bontorhumala/amelia-girl/models/CAD/snap 1.PNG

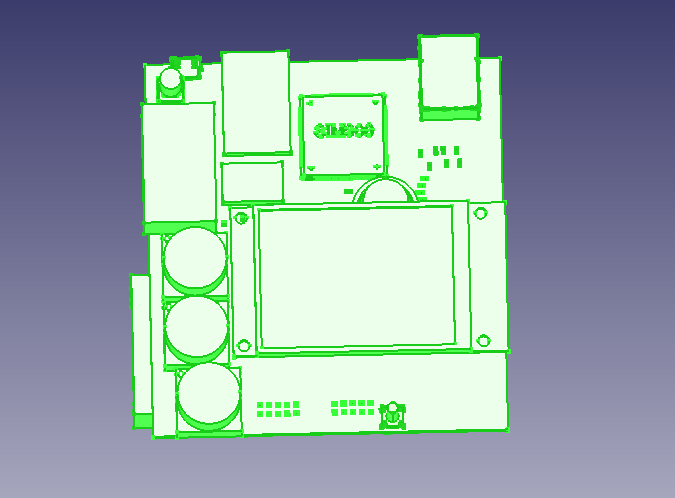
models/CAD/snap 1.PNG
