bontorhumala/amelia-girl/models/CAD/snap 3.PNG

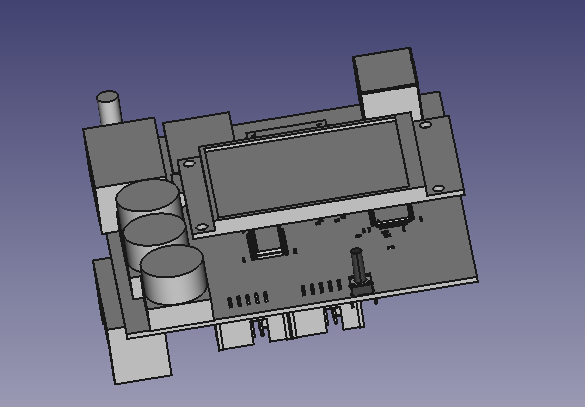
models/CAD/snap 3.PNG
