bontorhumala/amelia-girl/6lowPan/eagleUp/eagleUp_bontor_mbed_lowpan_rev_d_board_bottom.png

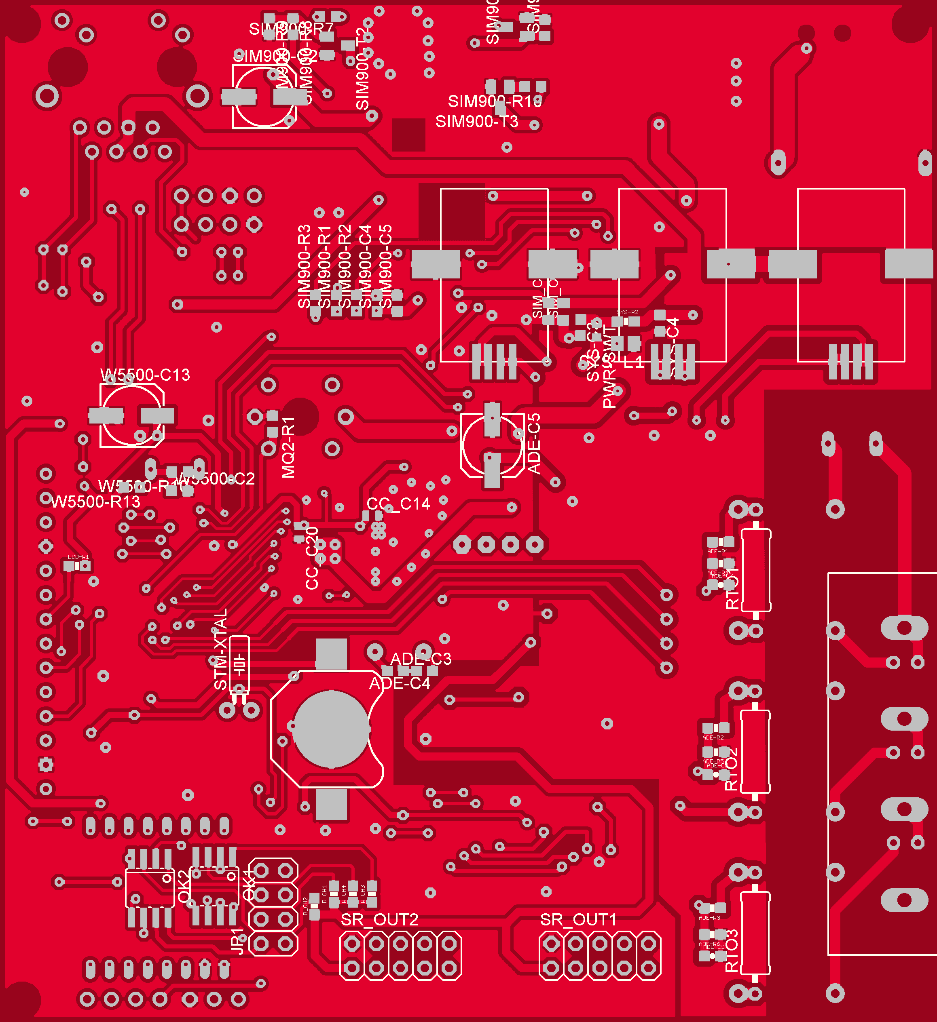
6lowPan/eagleUp/eagleUp_bontor_mbed_lowpan_rev_d_board_bottom.png
