bontorhumala/amelia-girl/6lowPan/eagleUp/eagleUp_bontor_mbed_lowpan_rev_d_board_top.png

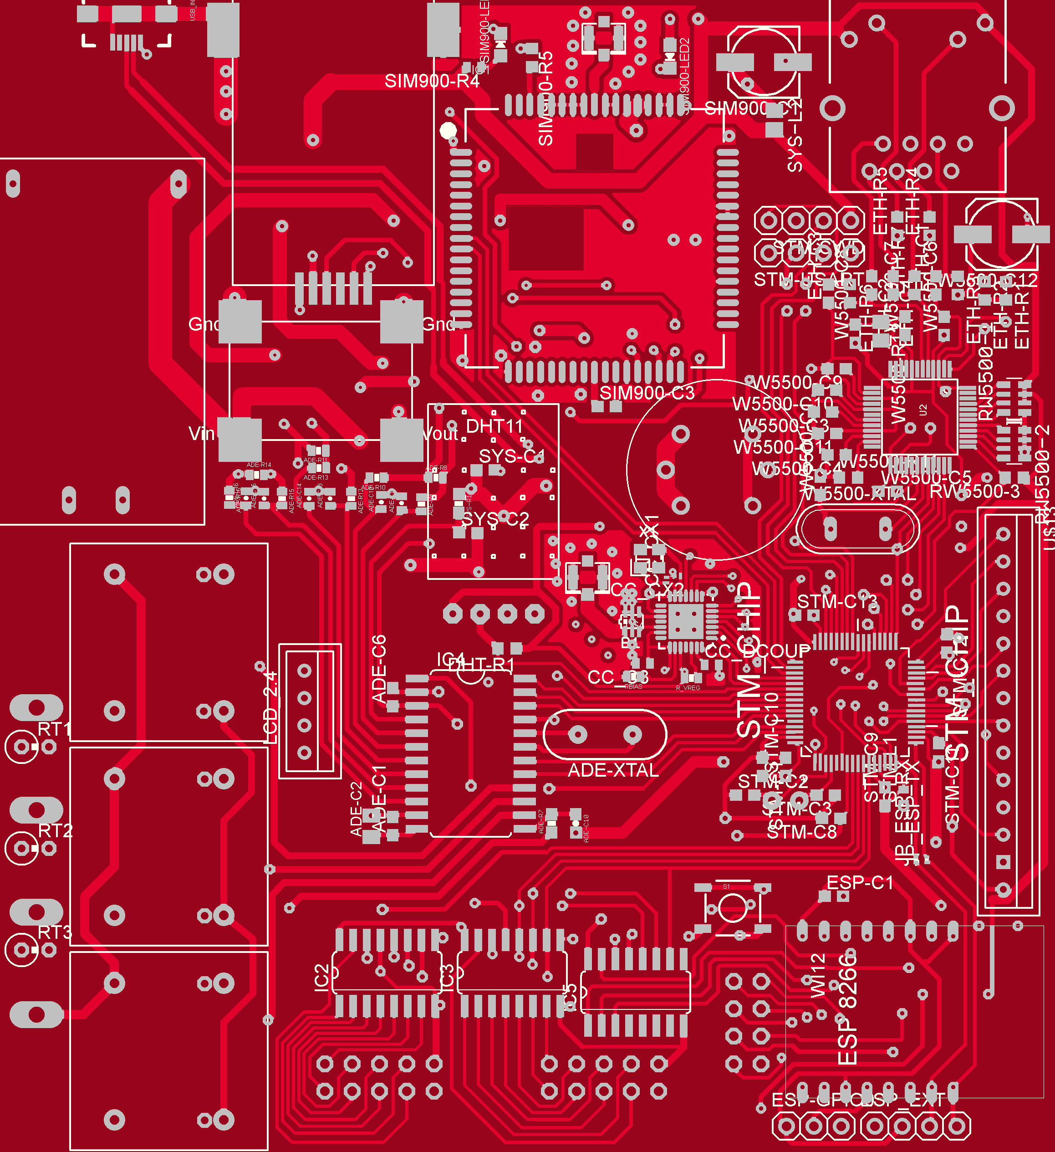
6lowPan/eagleUp/eagleUp_bontor_mbed_lowpan_rev_d_board_top.png
