bontorhumala/amelia-girl/mcb-enhancer/eagleUp/eagleUp_mcb-enhancer-v3_board_top.png

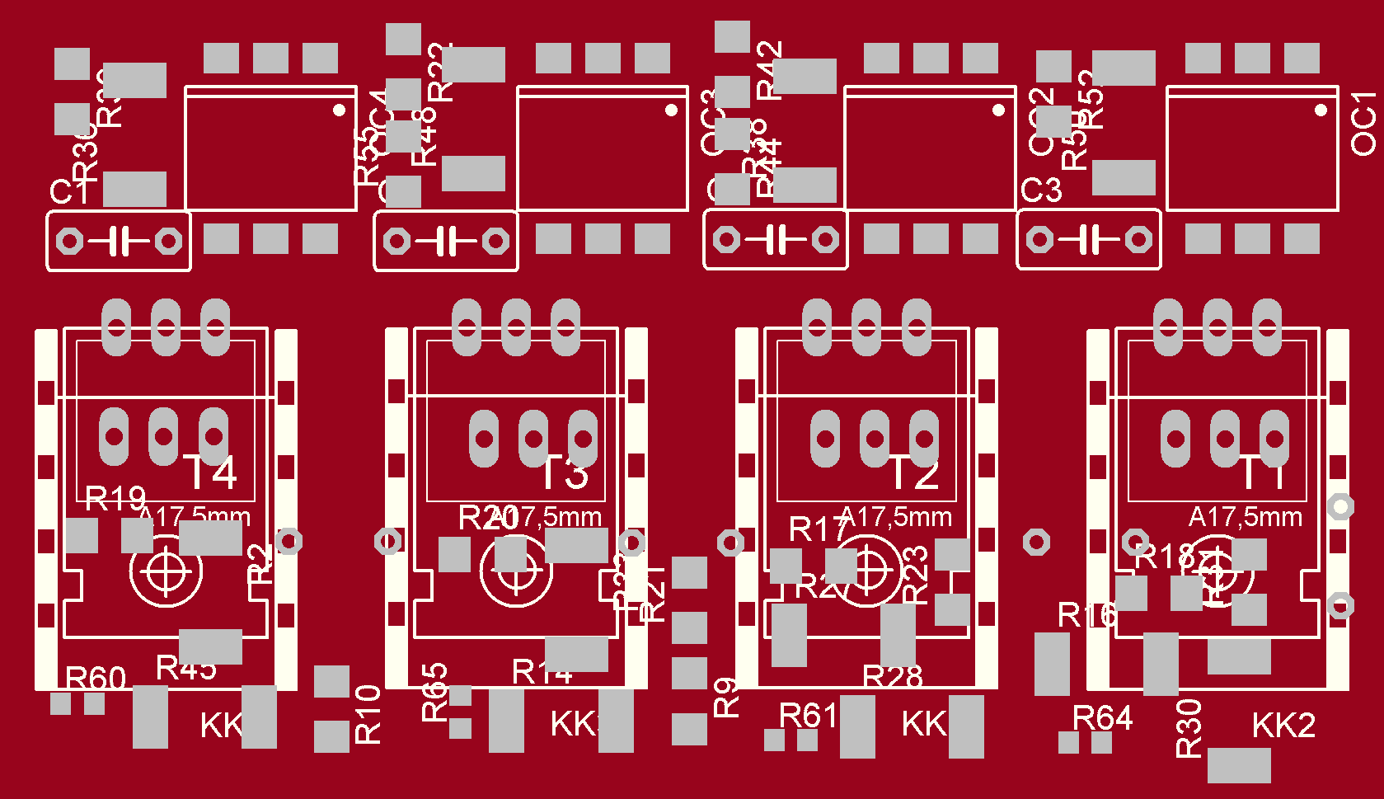
mcb-enhancer/eagleUp/eagleUp_mcb-enhancer-v3_board_top.png
