bontorhumala/amelia-girl/mcb-enhancer/eagleUp/eagleUp_mcb-enhancer-v4_board_bottom.png

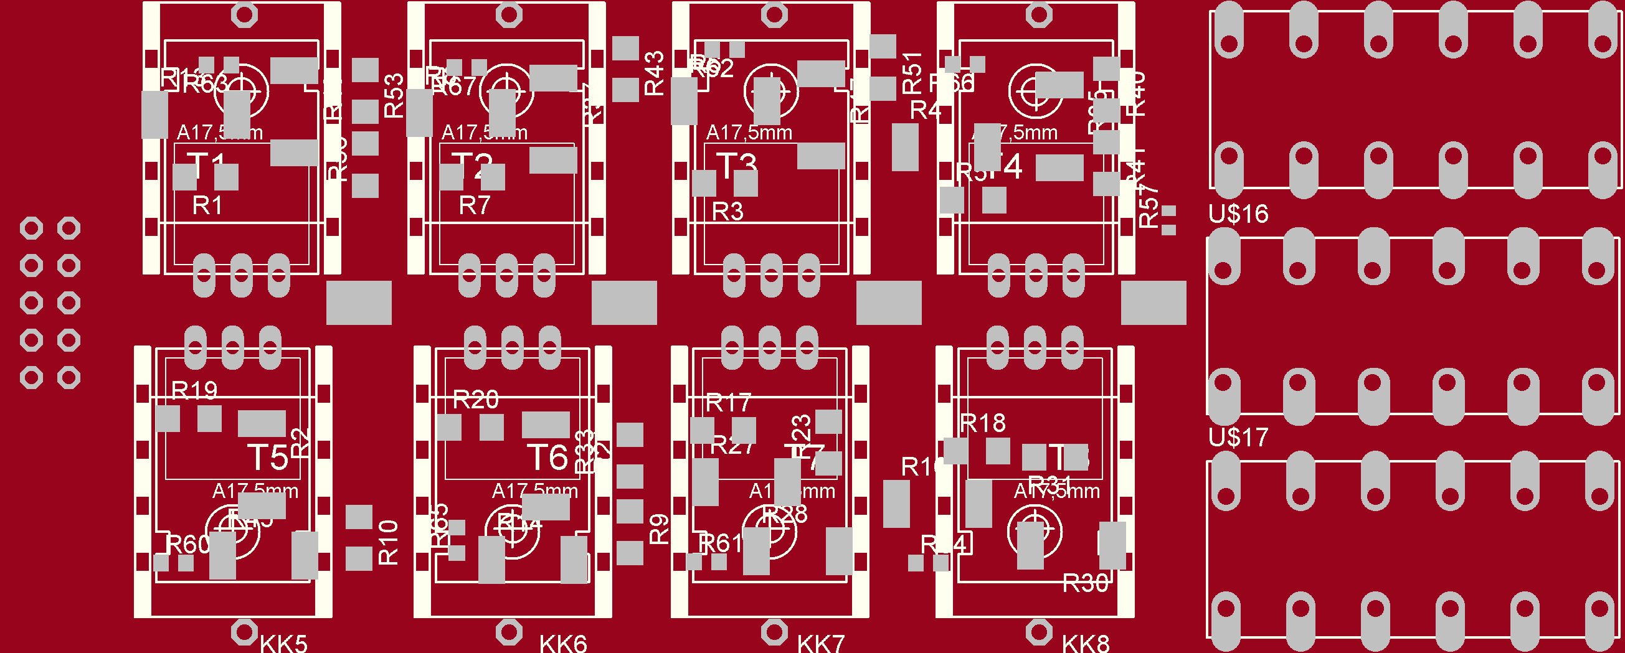
mcb-enhancer/eagleUp/eagleUp_mcb-enhancer-v4_board_bottom.png
