bontorhumala/amelia-girl/mcb-enhancer/eagleUp/eagleUp_mcb-enhancer-v4_board_top.png

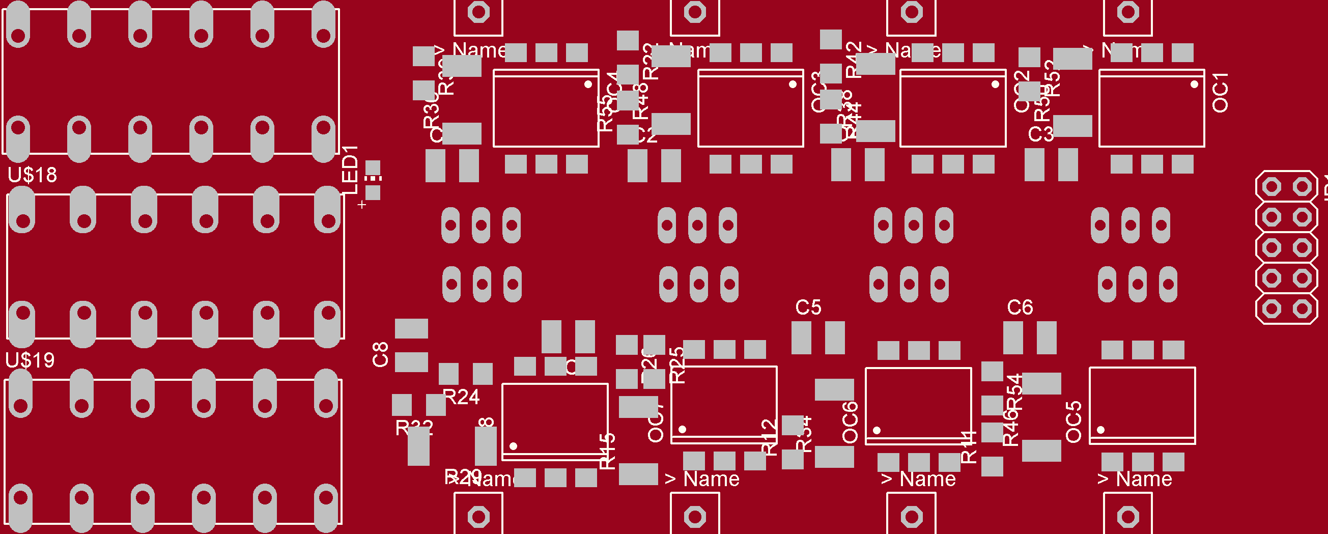
mcb-enhancer/eagleUp/eagleUp_mcb-enhancer-v4_board_top.png
