bontorhumala/amelia-girl/mcb-enhancer/eagleUp/eagleUp_mcb-enhancer-v5_board_top.png

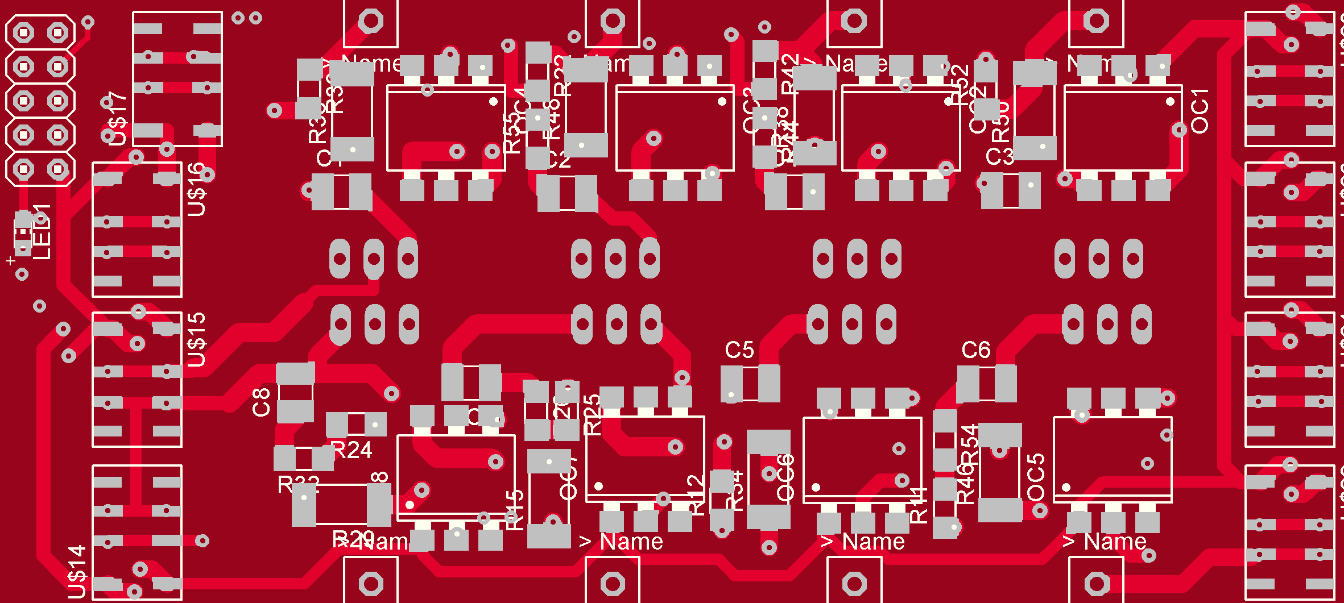
mcb-enhancer/eagleUp/eagleUp_mcb-enhancer-v5_board_top.png
