bontorhumala/amelia-girl/models/CAD/snap 2.PNG

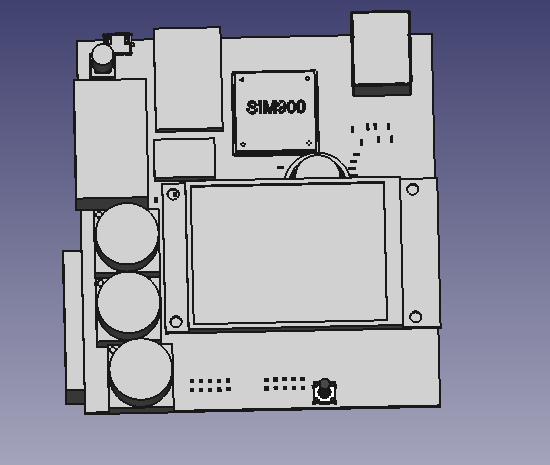
models/CAD/snap 2.PNG
