bontorhumala/amelia-girl/mcb-enhancer/production/Bella-BoM.xlsx

Ref | Part number | Description | Value | Amount | Link
LED1 | LED 0805 merah | Red LED SMD 0805 | - | 1 | Digikey (http://www.digikey.com/product-detail/en/LTST-C170TBKT/160-1579-1-ND/564889) |  | ok
JP1 | IDC2.54-2*5PL | Right angle pin header 5x2 | - | 1 | Aliexpress (http://www.aliexpress.com/item/Samples-10Pcs-lot-Right-Angle-Bend-2x5-10P-2-54mm-Spacing-IDC-Box-Pin-Header-Connector/1860612179.html) |  | ok
R57, R60, R61, R62, R63, R64, R65, R66, R67 | R0402 | Resistor SMD 0402, 16V | 330 Ohm | 9 | Digikey (http://www.digikey.com/product-detail/en/RC0402FR-07330RL/311-330LRCT-ND/729541) |  | ok
C1, C2, C3, C4, C5, C6, C7, C8 | C3225X7T2J104K160AC | Capacitor SMD 1210, minimum 600V - TDK Corp | 100 nF | 8 | Digikey (http://www.digikey.com/product-detail/en/C3225X7T2J104K160AC/445-7766-1-ND/2733838http:/www.digikey.com/product-detail/en/C3225X7T2J104K160AC/445-7766-2-ND/27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) |  | ok
R14, R15, R28, R29, R30, R34, R35, R36, R37, R38, R45, R46, R47, R48, R49, R50, R2, R4, R6, R8, R13, R16, R27, R33 | 1879524-2 | Resistor SMD 2512, 2Watt - TE Connectivity | 110 Ohm | 24 | Digikey (http://www.digikey.com/product-detail/en/2-2176070-6/A116009CT-ND/4279838) |  | ok
R11, R12, R21, R24, R25, R26, R32, R40, R41, R43, R44, R51, R53, R54, R55, R56, R9, R10, R22, R23, R31, R39, R42, R52 | - | Resistor SMD 1206, 1Watt 600V | 33 Ohm | 24 | Digikey (http://www.digikey.com/product-detail/en/HRG3216Q-33R0-D-T1/408-1916-1-ND/5762678) |  | ok
R1, R3, R5, R7, R17, R18, R19, R20 | - | Resistor SMD 1206, minimum 100V | 470 Ohm | 8 | Digikey (http://www.digikey.com/product-detail/en/HRG3216P-4700-D-T1/408-1923-1-ND/5762636) |  | ok
U$14, U$15, U$16, U$17, U$18, U$19, U$20, U$21, U$22, U$23, U$24, U$25, U$26, U$27, U$28, U$29 | 9-1462038-9 | TE Relay DPDT 250VAC, 5A contact rating, 5VDC coil | - | 16 | Alibaba (http://www.alibaba.com/product-detail/RELAY-TELECOM-DPDT-5A-5V-IM03DGR_777251191.html) | Digikey (http://www.digikey.com/product-detail/en/9-1462038-9/PB1172CT-ND/1828462) | ok
T1, T2, T3, T4, T5, T6, T7, T8 | BT139-600 | BT139 Triac | - | 8 | Aliexpress (http://www.aliexpress.com/item/10-PCS-BT139-600E-TO-220-BT139-600-BT139-Triacs-logic-level-600v-18A/32330478190.html) |  | ok
U$9, U$10, U$11, U$12 | HC617 | Hegxing Male PCB terminal HC617 | - | 4 | Manufacturer (http://hegxing.com/showpro.asp?id=200)
U$1, U$2, U$3, U$4, U$5, U$6, U$7, U$8 | 8737 | Mini female binding post connector Keystone Electronic | - | 8 | Digikey (http://www.digikey.com/product-search/en?mpart=8737&vendor=36) |  | ok
KK1, KK2, KK3, KK4, KK5, KK6, KK7, KK8 | EH22x15x10BN | Heatsink D02A-L | - | 8 | Aliexpress (http://www.aliexpress.com/item/FREE-Shipping-10pcs-22x15x10mm-Black-Anodize-Aluminum-Heatsink-Radiator-TO220-TO-220-Heatsink-RoHS-Compliant/1112371653.html) |  | ok
OC1, OC2, OC3, OC4, OC5, OC6, OC7, OC8 | MOC3041 SMD | Optocoupler zero crossing SMD type | - | 8 | Aliexpress (http://www.aliexpress.com/item/Free-shipping-10pcs-SMD8-300MIL-MOC3041SR2M-SMD-Optocoupler-MOC3041/32342960665.html) |  | ok
