bontorhumala/amelia-girl/6lowPan/Gerber and BoM/Gerber and BoM/ANNA-BoM.xlsx

Ref | Part number | Description | Value |  | Amount
RJ-1, RJ-2, RJ-3 | RJ11-4P4C-SMT | SMT RJ11 4 pin port |  | Alibaba link (http://wfdelec.en.alibaba.com/product/60105161069-800295882/RJ11.html) | 3
TERM_BLOCK | WJ45C-B-4P | 2 way 9.5mm terminal block 4 pin |  | Aliexpress link (http://www.aliexpress.com/item/Free-shipping-50Pcs-lot-Wholesale-B-Type-9-50mm-Pitch-4-Pins-PCB-Electrical-Screw-Terminal/720865581.html) | 1
BAT1 | 3000TR | 12mm battery holder |  | Digikey link (http://www.digikey.com/product-detail/en/3000TR/3000KCT-ND/1532229) | 1
LED1, LED2 | LED0805 | LED 0805 | red LED |  | 2
T1, T2, T3 | MMBT2222ALT1 | NPN transistor 2222 |  |  | 3
ESP-GPIO0 | PINHD-1x3 | Male pin header |  | Aliexpress link (http://www.aliexpress.com/item/Drop-Shipping-100x-40-Pin-2-54-mm-Single-Row-Pin-Male-Header-for-Arduino-Prototype/32284816337.html) | 1
JP1 | PINHD-2x4 | Male pin header |  | Aliexpress link (http://www.aliexpress.com/item/Drop-Shipping-100x-40-Pin-2-54-mm-Single-Row-Pin-Male-Header-for-Arduino-Prototype/32284816337.html) | 1
SR_OUT1, SR_OUT2 | PINHD-2x5 | Male pin header |  | Aliexpress link (http://www.aliexpress.com/item/Drop-Shipping-100x-40-Pin-2-54-mm-Single-Row-Pin-Male-Header-for-Arduino-Prototype/32284816337.html) | 2
ETHERNET | J0026D21BNL | RJ45 ethernet jack |  | Aliexpress link (http://www.aliexpress.com/item/Free-Shipping-New-Original-J0026D21BNL-J0026D21-CONN-MAGJACK-1PORT-100-BASE-TX-1x1-Tab-DOWN-RJ45/1584939626.html) | 1
S1 | TS6x6-15H | Tactile switch |  | Aliexpress link (http://binrong.en.alibaba.com/product/60204090810-801232003/Tactile_Tact_Push_Button_Switch_4_Pin_DIP_6x6x15mm.html) | 1
JRX, JTX, PWR | - | leave this unassembled |  |  | -
XTAL2 | CRYSTALHC49US | Crystal 25MHz | 25 MHz |  | 1
XTAL1 | CRYSTALTC26H | Crystal TC26H 32.768 kHz | 32.768 kHz | Aliexpress link (http://www.aliexpress.com/item/Bole-electronic-cylinder-crystals-32-768-KHZ/32326333706.html) | 1
ADE-XTAL | CRYSTALHC49US | Crystal 10MHz | 10 MHz |  | 1
L1, L2 | BLM21PG600SN1D | Ferrite bead 0805 | 150 MHz, 60 Ohm |  | 2
B1 | 2450BM15A0002 | Balun 2.4 GHz for CC2520 |  | Aliexpress link (http://www.aliexpress.com/item/Free-shipping-10PCS-2450BM15A0002E-2450BM15A0002/32249585843.html) | 1
C36 | C0603 | Capacitor SMD 0603 | 22nF |  | 1
C54, C57 | C0603 | Capacitor SMD 0603 | 18pF |  | 2
C73, C74, SIM900-C5, C81 | C0603 | Capacitor SMD 0603 | 22pF |  | 4
C43, C46, C41, C40, C27 | C0402 | Capacitor SMD 0402 | 100nF |  | 4
C80, C71, SYS-C1, SYS-C2, C10, C11, C70, ESP-C1, SIM900-C4, C20, C25, C24, C26, STM-C13, C56, C35, C33, C31, C50, C51, C53 | C0603 | Capacitor SMD 0603 | 100nF |  | 22
C96, C97 | C0605 | Capacitor alumunium SMD polar 0605 | 100uF | Aliexpress link (http://www.aliexpress.com/item/SMD-aluminum-electrolytic-capacitor-16V-100UF-6X5-4-100UF-16V-6-5-4-Original-new-Special/32260015566.html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) | 2
ETH-C3, C55 | C0603 | Capacitor SMD 0603 | 10nF |  | 2
ADE-C5, C37, W5500-C13 | C0605 | Capacitor alumunium SMD polar 0605 | 10uF | Aliexpress link (http://www.aliexpress.com/item/SMD-16V-10UF-4-5MM-50PCS-SMD-Chip-Aluminum-Electrolytic-Capacitors-100-good-quality-Free-shipping/1931606471.html) | 3
C23 | C0603 | Capacitor SMD 0603 | 1uF |  | 1
C72 | C0805 | Capacitor SMD 0805 | 10uF |  | 1
R96, R90, DHT-R1, MQ2-R1, R51, R50, R54 | R0603 | Resistor SMD 0603 | 10k Ohm |  | 7
R33, SYS-R1, R10 | R0603 | Resistor SMD 0603 | 10 Ohm |  | 3
R53, R52 | 742C083103JP | Resistor array SMD 0603 | 10k Ohm |  | 2
R_VREG | R0402 | Resistor SMD 0402 | 10k Ohm |  | 1
RTO1, RTO2, RTO3 | R0309 | Resistor 1/2 W | 3.9k Ohm | Aliexpress link (http://www.aliexpress.com/item/1-2w-Watt-3-9k-ohm-3-9-k-Metal-Film-Resistor-0-5-W-1/32254022870.html) | 3
RT1, RT2, RT3 | R0309 | Resistor 1/2 W | 100k Ohm | Aliexpress link (http://www.aliexpress.com/item/1-2w-Watt-100k-ohm-100-k-Metal-Film-Resistor-0-5-W-1-20pcs/32253966620.html) | 3
R93, SIM900-R11 | R0603 | Resistor SMD 0603 | 120 Ohm |  | 2
R31 | R0805 | Resistor SMD 0805 | 12.4k Ohm |  | 1
ADE-R9, ADE-R10, ADE-R12, ADE-R13, ADE-R15, ADE-R16 | R0402 | Resistor SMD 0402 | 1k Ohm |  | 6
R95, SIM900-R91, ADE-R4, ADE-R5, ADE-R6, ADE-R7 | R0603 | Resistor SMD 0603 | 1k Ohm |  | 6
R56 | R0603 | Resistor SMD 0603 | 1M Ohm |  | 1
SIM900-R1, SIM900-R2, SIM900-R3 | R0603 | Resistor SMD 0603 | 22 Ohm |  | 3
R_CH1, R_CH2, R_CH3, R_CH4 | R0603 | Resistor SMD 0603 | 270 Ohm |  | 4
C44, C45 | C0201 | Capacitor SMD 0201 | 27pF |  | 2
ETH-R4, ETH-R5 | R0603 | Resistor SMD 0603 | 330 Ohm |  | 2
ADE-R8, ADE-R11, ADE-R14 | R0402 | Resistor SMD 0402 | 33 Ohm |  | 3
ADE-C11, ADE-C12, ADE-C13, ADE-C14, ADE-C15, ADE-C16 | C0402 | Capacitor SMD 0402 | 33nF |  | 6
ADE-C7, ADE-C8, ADE-C9, ADE-C10 | C0603 | Capacitor SMD 0603 | 33nF |  | 4
C22, C21 | C0603 | Capacitor SMD 0603 | 4.3pF |  | 2
C52, SIM900-C3 | C0603 | Capacitor SMD 0603 | 4.7uF |  | 2
R35, R34, R30, R32 | R0603 | Resistor SMD 0603 | 49.9 Ohm |  | 4
RBIAS | R0402 | Resistor SMD 0402 | 56k Ohm |  | 1
C32, C34 | C0603 | Capacitor SMD 0603 | 6.8nF |  | 2
R92 | R0603 | Resistor SMD 0603 | 680 Ohm |  | 2
R94 | R0603 | Resistor SMD 0603 | 680 Ohm |  | 1
IC2, IC3, IC5 | 74HC595D | 74HC595D MUX chip SOIC16 package | 74HC595D |  | 3
ADE-R1, ADE-R2, ADE-R3 | R0603 | Resistor SMD 0603 | 81k Ohm |  | 3
IC4 | ADE7758ARWZ | ADE7758 energy measurement IC from Analog Device | ADE7758ARWZ | Aliexpress link (http://www.aliexpress.com/item/Brand-new-original-authentic-ADE7758ARWZ-ADE7758-SOP24-three-phase-electric-energy-metering-chip-XJDZ/32218347621.html) | 1
L3 | BLM15HB121SN1 | Ferrite bead 0402 100MHz, 120 Ohm | 120 Ohm, 100 MHz |  | 1
U$4 | CC2520 | CC2520 802.15.4 RF Interface IC from TI in QFN package | CC2520 | Aliexpress link (http://www.aliexpress.com/item/Free-shipping-10PCS-CC2520/1896301052.html) | 1
DCDC | Mini-360 | Ultra small DC-DC module using LM2596 | Mini-360 | Aliexpress link (http://www.aliexpress.com/item/Mini-360-DC-Buck-Converter-Step-Down-Module-4-75V-23V-to-1V-17V-17x11x3-8mm/2036532381.html) | 1
U$5 | ESP-12 | ESP8266 module type 12 | ESP-12 | Aliexpress link (http://www.aliexpress.com/item/5pcs-esp-12-wifi-module-esp8266-remote-serial-port-wifi-wireless-module-coexistence-wireless-transceiver-module/32254606243.html) | 1
OK1, OK2 | ILD205T | ILD205 optocoupler IC | ILD205 |  | 2
LCD14 |  | 14pin and 4pin connector for LCD module | 4 pin link (http://www.aliexpress.com/item/50PCS-Pitch-2-54mm-1x4-Pin-4-Pin-Female-Single-Row-Straight-Pin-Header-Strip-Connector/32329271924.html) | 14 pin link (http://www.aliexpress.com/item/14-Pin-Female-pin-header-2-54-Socket-Connector/1942895138.html) | 1
SENSOR-MQ2 | MQ2 | MQ2 gas sensor module | MQ2 | Aliexpress link (http://www.aliexpress.com/item/10PCS-MQ-2-MQ2-Smoke-Gas-Alcohol-Detector-Sensor-Module-free-shipping/581953194.html) | 1
X1 | NX2520SA-32.000000MHZ | 32MHz FA-20H crystal | 32Mhz |  | 1
ESP_EXT, STM-SWD, STM-USART | 1223122 4 pin header | 4 pin 2.54 mm pitch male pin header | 4 pin | Aliexpress link (http://www.aliexpress.com/item/Drop-Shipping-100x-40-Pin-2-54-mm-Single-Row-Pin-Male-Header-for-Arduino-Prototype/32284816337.html) | 3
IC1 | SIM900 | SIM900 GPRS chipset | SIM900 |  | 1
SIMHOLDER | AndTech | AndTech push-push type sim holder | Andtech | Aliexpress link (http://www.aliexpress.com/item/push-push-type-Simcard-Holder-Sim-card-socket/491950841.html) | 1
STMF401 | STM32F401RET6 | STM32F401 ARM microcontroller 64 pin LQFP from ST Micro | STM32F401 |  | 1
TV16-1, TV16-2, TV16-3 | TV16 | YHDC TV16 2.5mm transformer | TV16 | Aliexpress link (http://www.aliexpress.com/item/YHDC-TV16-250V-2mA-PCB-mount-Voltage-transformer/32294917189.html) | 3
ANT1, ANT2 | IPX 20279-001E | U.FL SMD connector | IPX 20279-001E |  | 2
U2 | W5500 | W5500 ethernet interface chip | W5500 |  | 1
USB_IN | MISB-SW-5B | Micro USB SMD connector |  | link (http://m.morethanall.com/product/index/btype_id/7/type_id/81) | 1
HLK-PM01 | HLK-PM01 | AC DC adaptor module from HLK Tech |  | link (http://www.hlktech.net/product_detail.php?ProId=54) | 1
U$17 | DHT11 | DHT11 temperature humidity sensor |  |  | 1
C28 | C0603 | Capacitor SMD 0603 | 4.7uF, 25V, ESR < 1 Ohm |  | 1
S2 | PUSH SWITCH | 6pin 2.54mm spacing locked push switch (with white cap) |  | switch (http://www.aliexpress.com/item/ZLKG023-100pcs-8-8-pitch-2-54mm-without-lock-reset-switch-key-switch-6-pin-NEW/32335128157.html) | 1
 |  |  |  | cap (http://www.aliexpress.com/item/100pcs-7-color-A04-Tactile-Push-Button-Switch-Cap-tact-micro-switch-button-Cap-fit-7/32285421383.html) | 1
ACCESSORIES
SCT-013 |  | Current sensor with RJ11 jack |  | alibaba link (http://www.alibaba.com/product-detail/Split-core-current-transformer-SCT-013_1883221415.html) | 1
LCD 2.4inch |  | LCD TFT with touch capabilities 2.4inch |  | aliexpress link (http://www.aliexpress.com/item/2-4-2-4inch-240x320-SPI-Serial-port-TFT-LCD-touch-Screen-Module-display-PCB-panel/32255313573.html) | 1
GPRS antenna |  | PCB antenna for SIM900 GPRS |  | aliexpress link (http://www.aliexpress.com/item/Free-Shipping-GSM-WCDMA-CDMA-built-in-antenna-Flat-antenna-WiFi-3G-antenna-Compatible-with-SIM900/1295992611.html) | 1
