bontorhumala/amelia-girl/models/CAD/Casing (Lower-Upper) ver01/Casing (Lower-Upper) ver01.STEP

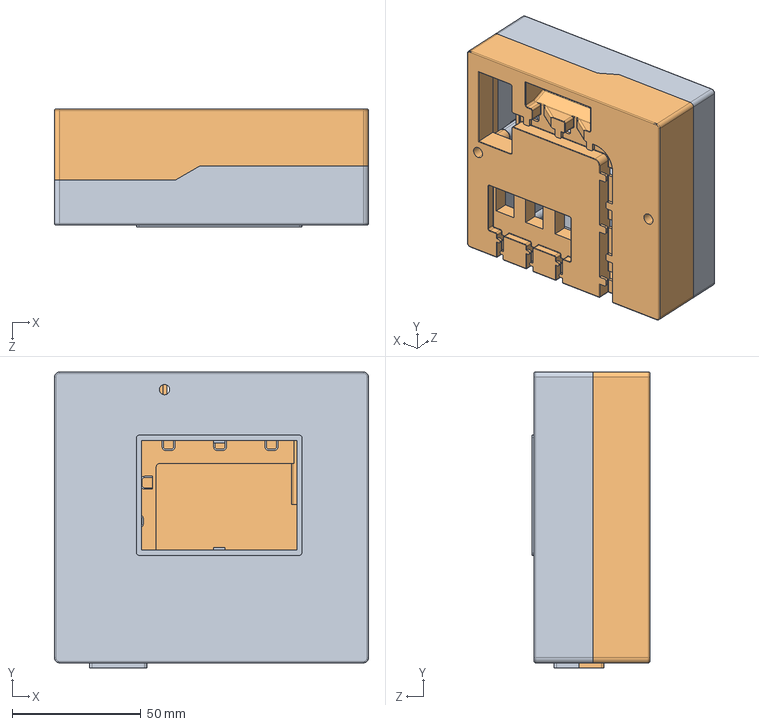
[picture p14: CAD file, 2015-06-09]
models/CAD/Casing (Lower-Upper) ver01/Casing (Lower-Upper) ver01.STEP
122.0 x 115.0 x 45.8 mm
