bontorhumala/amelia-girl/models/Model/Emma_Finished.stl

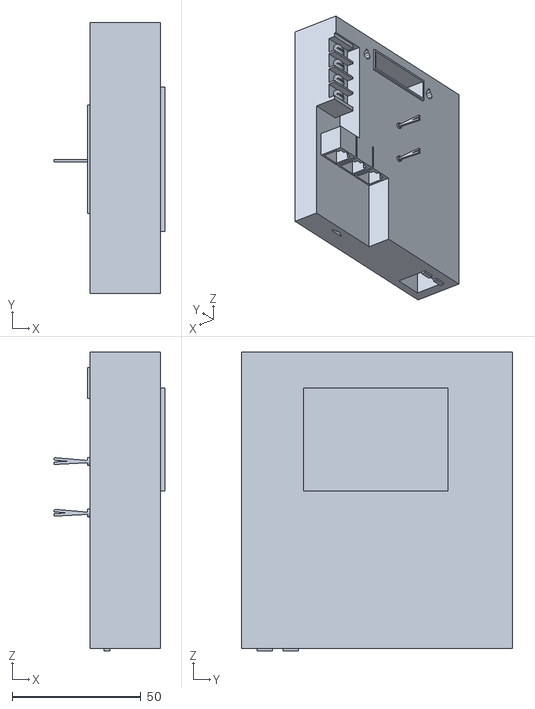
[picture p15: CAD file, 2015-05-19]
models/Model/Emma_Finished.stl
43.0 x 105.0 x 116.0
