bontorhumala/amelia-girl/(list of files, cad)

Other CAD files:
mcb-enhancer/models/mcb-enhancer-complete.skp
mcb-enhancer/models/mcb-enhancer-connector.skp
mcb-enhancer/models/mcb-enhancer-terminal.skp
mcb-enhancer/models/mcb-enhancer.skp
models/Model/Emma_Finished.obj
