bontorhumala/amelia-girl/models/LCD Mounting Guide.pptx

## Mounting Guide

- LCD yang dipakai punya 4 mounting hole
- Di mounting guide, baut dipasang di display ke bezel (casing). Bezel adl nama bagian casing yang miring
- Jadi, baut bakal dipasang pada mounting hole LCD, ke bezel di casing

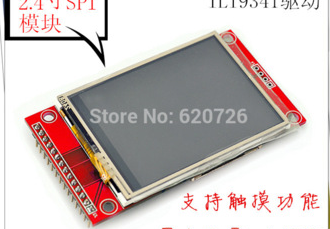
[picture p16: figure]

Mounting hole dibaut ke bezel

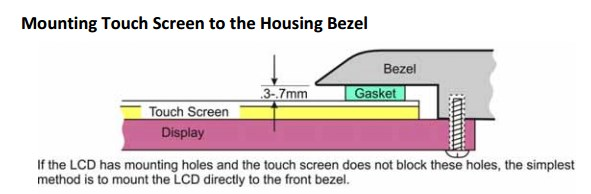
[picture p17: figure]

## Implementasi

- Keempat tonjolan yang lu buat bisa jadi screwhole buat baut si lcd
- Masalahnya kalo tonjolan screw hole nya ketinggian, LCD bakal masuk ke dalam
- Tonjolannya pendek saja supaya LCD nya tetep nongol, yang discrew boardnya aja

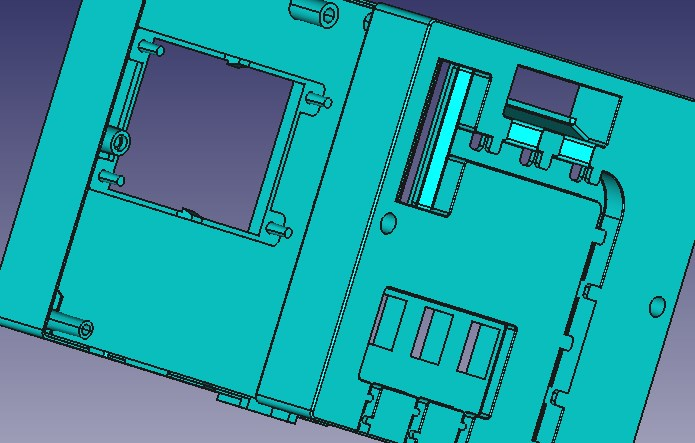
[picture p18: figure]

## Model Screwhole Menonjol

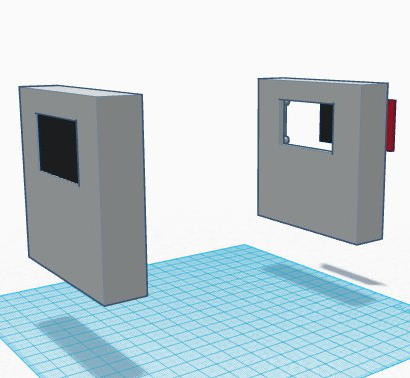
[picture p19: figure]
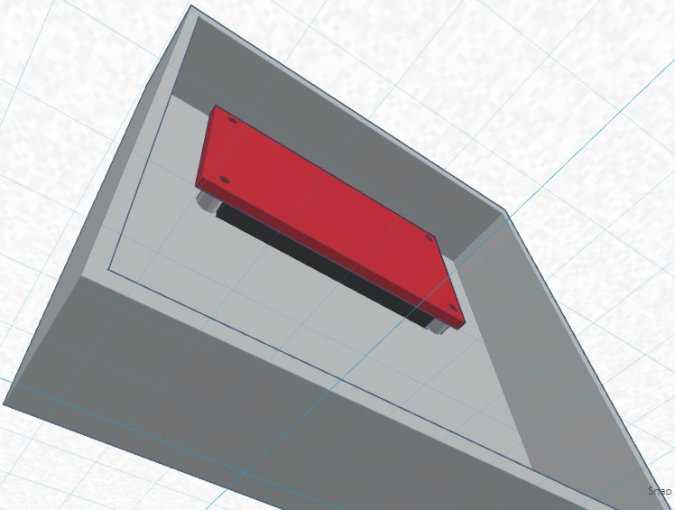
[picture p20: figure]

- Screwhole muncul dari casing (area bezel) dan dibaut ke board/bodi LCD
- Mengingat ketebalan LCD yang tipis, tonjolan screwholenya pendek saja supaya jarak antara LCD dan bezel tidak terlalu jauh

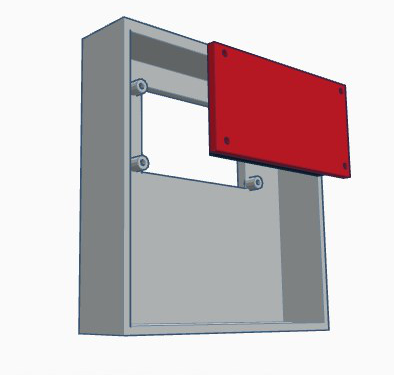
[picture p21: figure]

Tonjolan screwhole
