bontorhumala/amelia-girl/mcb-enhancer/mcb-enhancer-v5.brd

## EAGLE design mcb-enhancer/mcb-enhancer-v5.brd (2015-12-18)

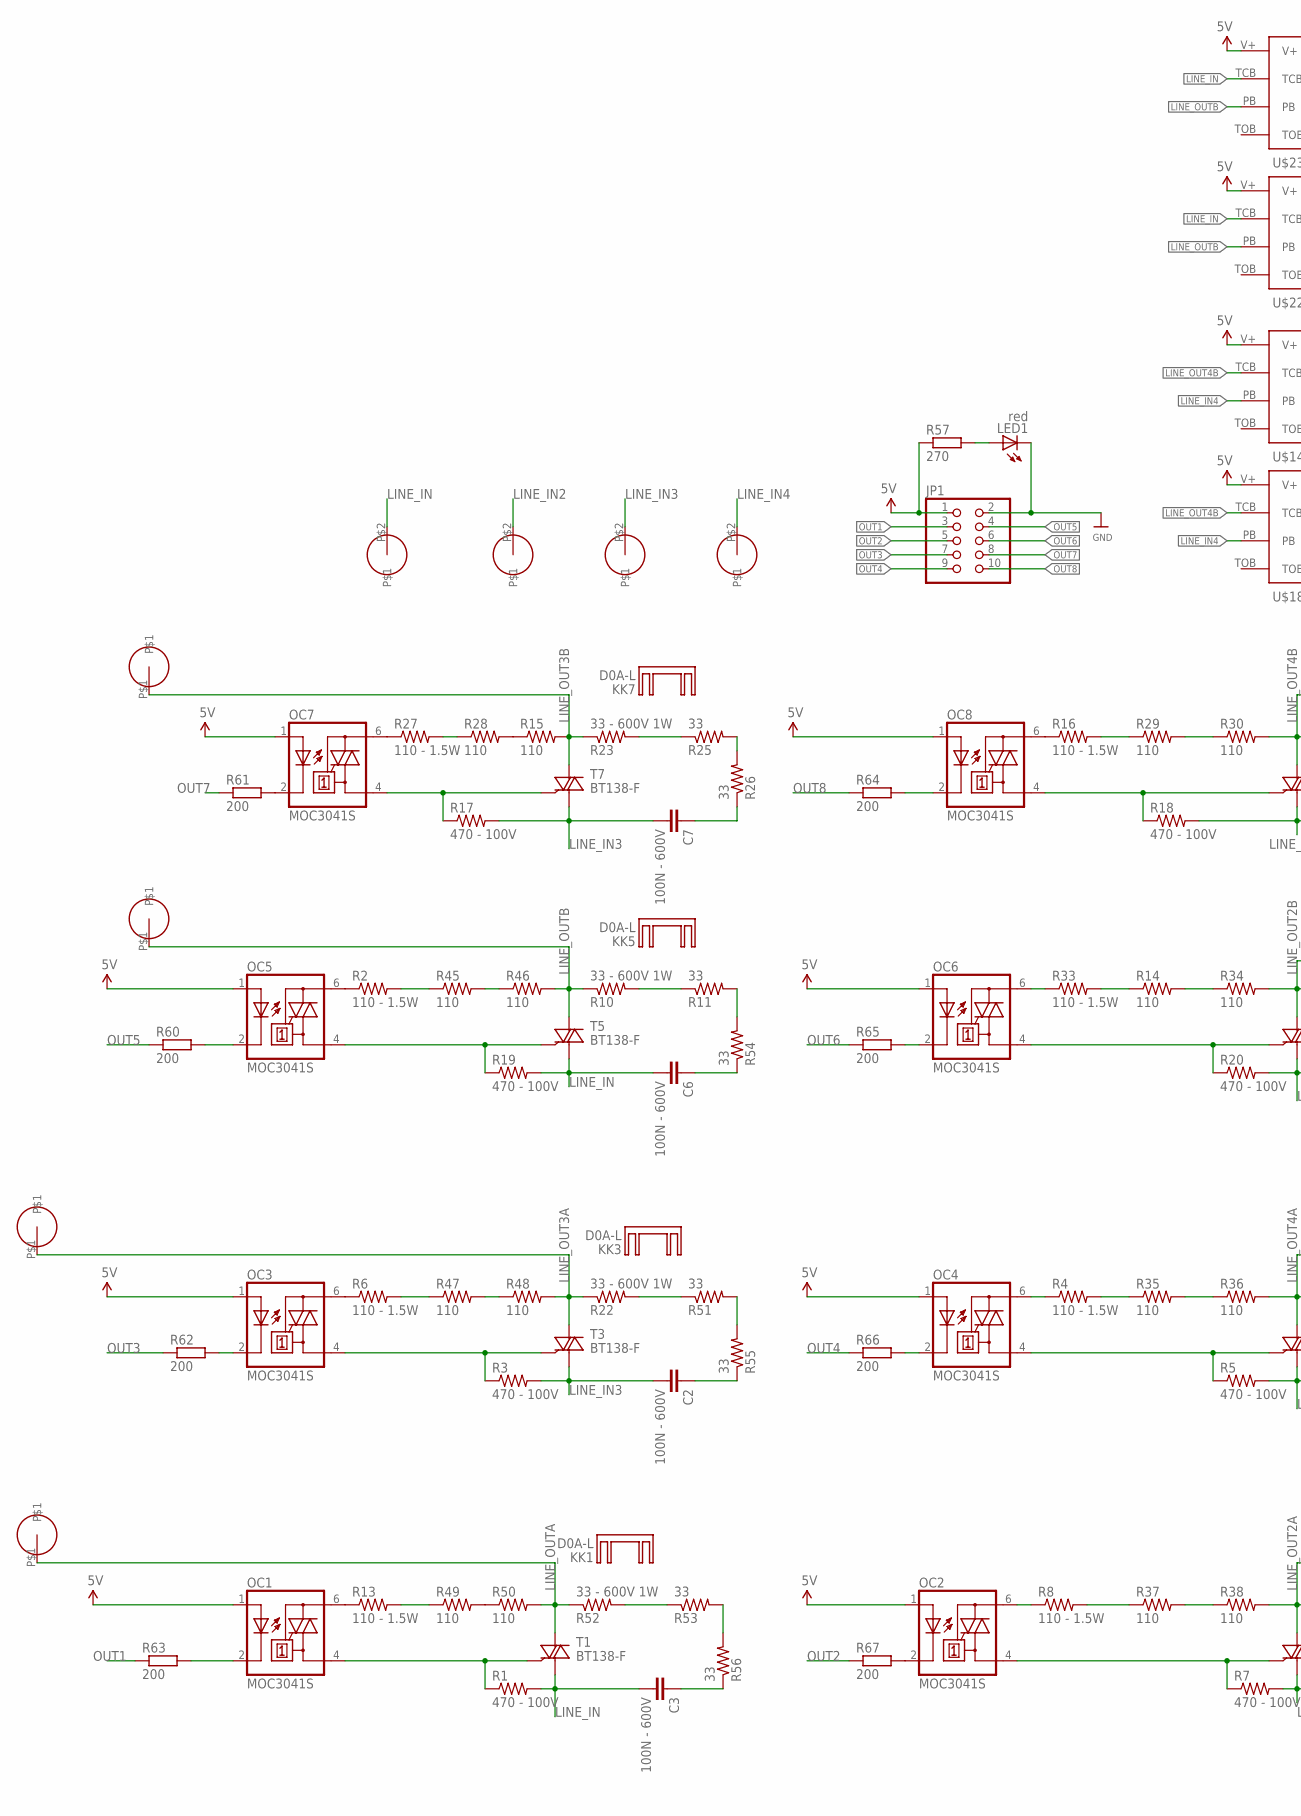
[picture p22: schematic mcb-enhancer-v5.sch, part in row 1, column 1]

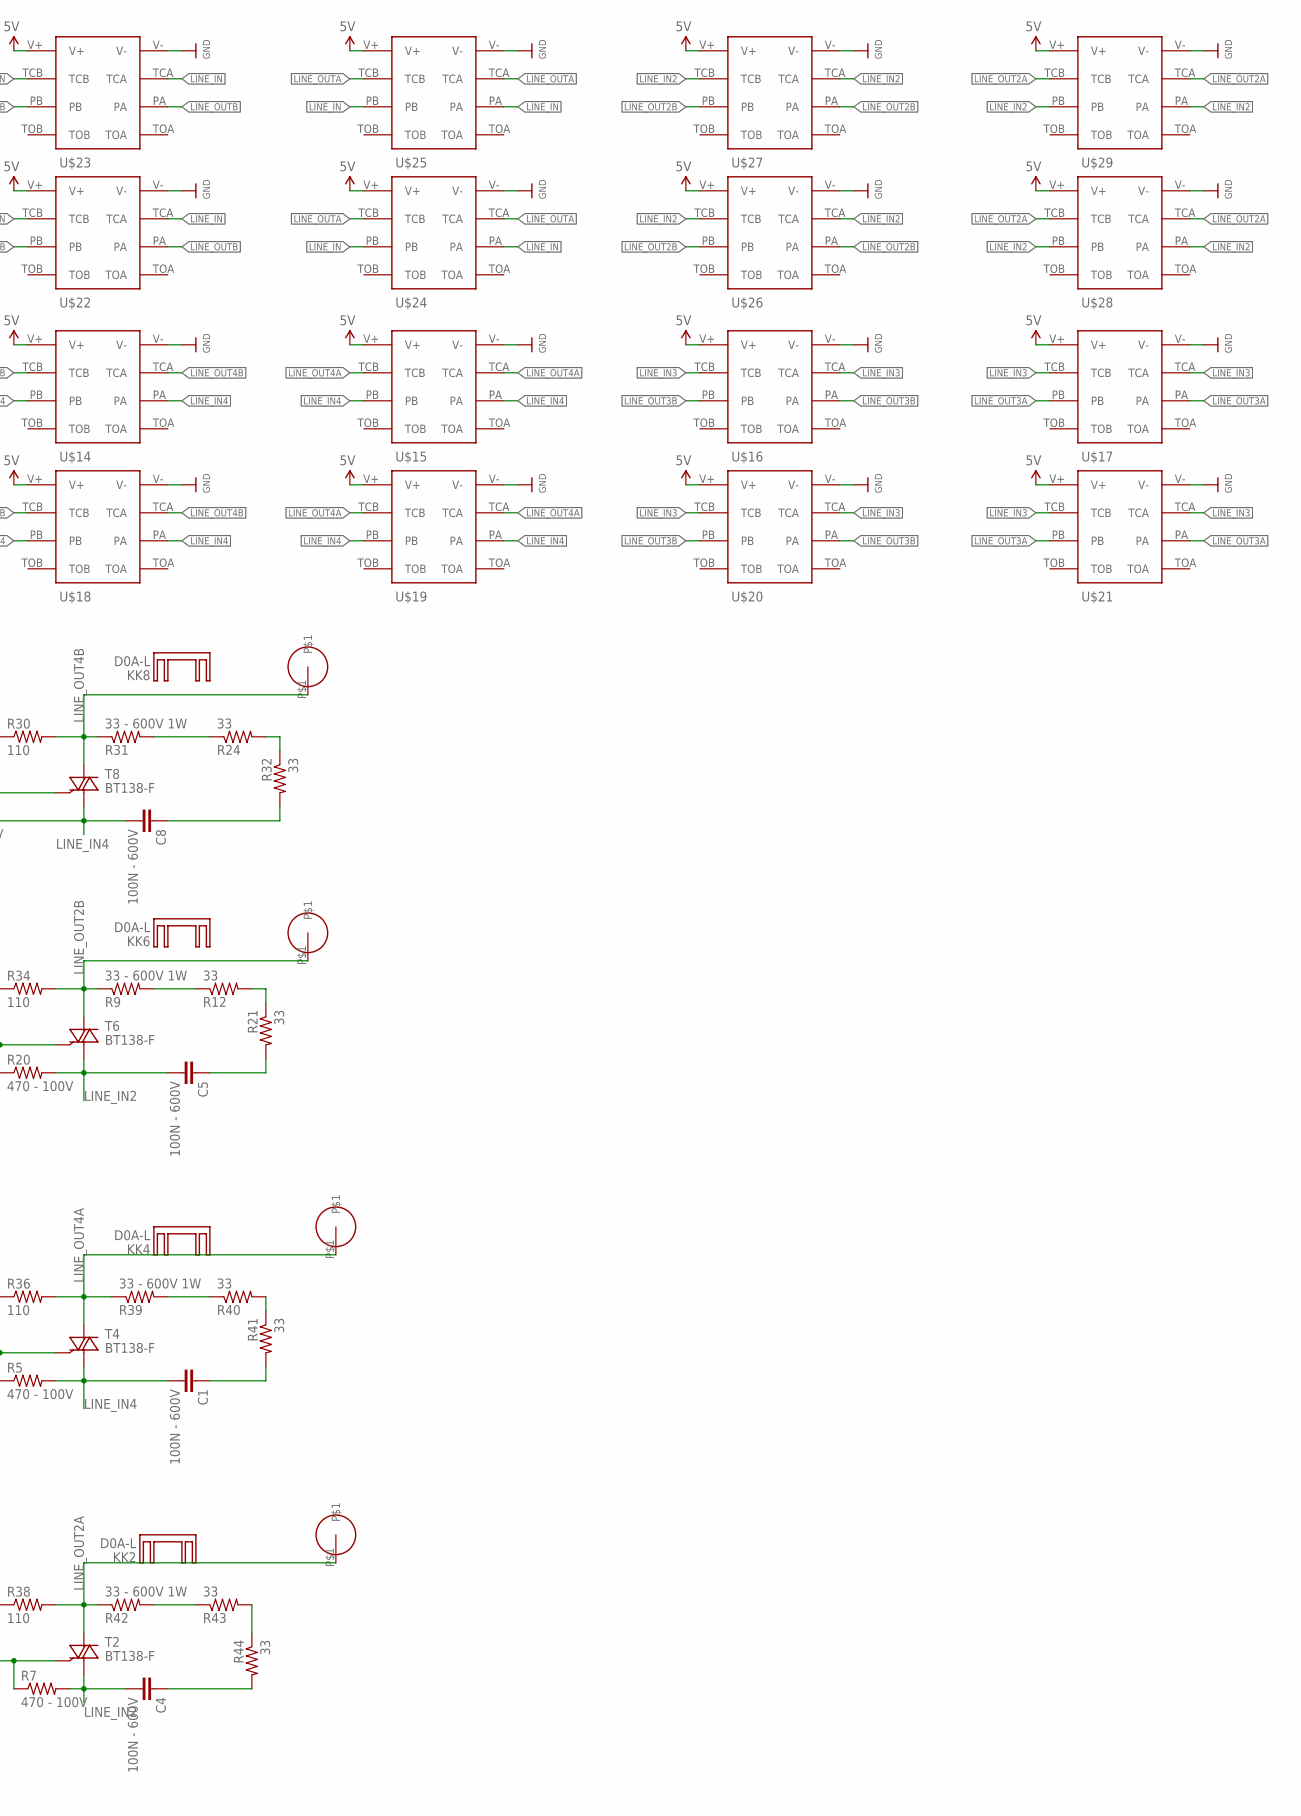
[picture p23: schematic mcb-enhancer-v5.sch, part in row 1, column 2]

Parts:
C1, C2, C3, C4, C5, C6, C7, C8: 100N - 600V; C1210
JP1: PINHD-2X5; 2X05
KK1, KK2, KK3, KK4, KK5, KK6, KK7, KK8: D0A-L; D02A-L
LED1: red; CHIP-LED0805
OC1, OC2, OC3, OC4, OC5, OC6, OC7, OC8: MOC3041S; DIL6-SMD; MPN MOC3033S-M
R1, R3, R5, R7, R17, R18, R19, R20: 470 - 100V; R1206
R2, R4, R6, R8, R13, R16, R27, R33: 110 - 1.5W; R2512
R9, R10, R22, R23, R31, R39, R42, R52: 33 - 600V 1W; R1206
R11, R12, R21, R24, R25, R26, R32, R40, R41, R43, R44, R51, R53, R54, R55, R56: 33; R1206
R14, R15, R28, R29, R30, R34, R35, R36, R37, R38, R45, R46, R47, R48, R49, R50: 110; R2512
R57: 270; R0402
R60, R61, R62, R63, R64, R65, R66, R67: 200; R0603
T1, T2, T3, T4, T5, T6, T7, T8: BT138-F; TO220BF
U$1, U$2, U$3, U$4, U$5, U$6, U$7, U$8: CONN-SCREW-MINI
U$9, U$10, U$11, U$12: CONN; HC617
U$14, U$15, U$16, U$17, U$18, U$19, U$20, U$21, U$22, U$23, U$24, U$25, U$26, U$27, U$28, U$29: 9-1462038-9; TE-9-1462038-9

Connections:
5V: JP1.1, OC1.1 (A), OC2.1 (A), OC3.1 (A), OC4.1 (A), OC5.1 (A), OC6.1 (A), OC7.1 (A), OC8.1 (A), R57.1, U$14.V+, U$15.V+, U$16.V+, U$17.V+, U$18.V+, U$19.V+, U$20.V+, U$21.V+, U$22.V+, U$23.V+, U$24.V+, U$25.V+, U$26.V+, U$27.V+, U$28.V+, U$29.V+
GND: JP1.2, LED1.C, U$14.V-, U$15.V-, U$16.V-, U$17.V-, U$18.V-, U$19.V-, U$20.V-, U$21.V-, U$22.V-, U$23.V-, U$24.V-, U$25.V-, U$26.V-, U$27.V-, U$28.V-, U$29.V-
LINE_IN: C3.2, C6.2, R1.2, R19.2, T1.T1 (A1), T5.T1 (A1), U$9.P$2, U$22.TCA, U$22.TCB, U$23.TCA, U$23.TCB, U$24.PA, U$24.PB, U$25.PA, U$25.PB
LINE_IN2: C4.2, C5.2, R7.2, R20.2, T2.T1 (A1), T6.T1 (A1), U$10.P$2, U$26.TCA, U$26.TCB, U$27.TCA, U$27.TCB, U$28.PA, U$28.PB, U$29.PA, U$29.PB
LINE_IN3: C2.2, C7.2, R3.2, R17.2, T3.T1 (A1), T7.T1 (A1), U$11.P$2, U$16.TCA, U$16.TCB, U$17.TCA, U$17.TCB, U$20.TCA, U$20.TCB, U$21.TCA, U$21.TCB
LINE_IN4: C1.2, C8.2, R5.2, R18.2, T4.T1 (A1), T8.T1 (A1), U$12.P$2, U$14.PA, U$14.PB, U$15.PA, U$15.PB, U$18.PA, U$18.PB, U$19.PA, U$19.PB
LINE_OUT2A: R38.2, R42.1, T2.T2 (A2), U$2.P$1, U$28.TCA, U$28.TCB, U$29.TCA, U$29.TCB
LINE_OUT2B: R9.1, R34.2, T6.T2 (A2), U$6.P$1, U$26.PA, U$26.PB, U$27.PA, U$27.PB
LINE_OUT3A: R22.1, R48.2, T3.T2 (A2), U$3.P$1, U$17.PA, U$17.PB, U$21.PA, U$21.PB
LINE_OUT3B: R15.2, R23.1, T7.T2 (A2), U$7.P$1, U$16.PA, U$16.PB, U$20.PA, U$20.PB
LINE_OUT4A: R36.2, R39.1, T4.T2 (A2), U$4.P$1, U$15.TCA, U$15.TCB, U$19.TCA, U$19.TCB
LINE_OUT4B: R30.2, R31.1, T8.T2 (A2), U$8.P$1, U$14.TCA, U$14.TCB, U$18.TCA, U$18.TCB
LINE_OUTA: R50.2, R52.1, T1.T2 (A2), U$1.P$1, U$24.TCA, U$24.TCB, U$25.TCA, U$25.TCB
LINE_OUTB: R10.1, R46.2, T5.T2 (A2), U$5.P$1, U$22.PA, U$22.PB, U$23.PA, U$23.PB
unnamed: OC5.6 (A2), R2.1
unnamed: OC2.6 (A2), R8.1
unnamed: OC3.4 (A1), R3.1, T3.G
unnamed: OC3.6 (A2), R6.1
unnamed: OC4.4 (A1), R5.1, T4.G
unnamed: OC1.2 (C), R63.2
unnamed: R9.2, R12.1
unnamed: R49.2, R50.1
unnamed: R52.2, R53.1
unnamed: OC1.6 (A2), R13.1
unnamed: OC1.4 (A1), R1.1, T1.G
unnamed: R8.2, R37.1
unnamed: OC2.4 (A1), R7.1, T2.G
unnamed: R45.2, R46.1
unnamed: OC2.2 (C), R67.2
unnamed: R23.2, R25.1
unnamed: R25.2, R26.2
unnamed: OC3.2 (C), R62.2
unnamed: OC4.2 (C), R66.2
unnamed: C7.1, R26.1
unnamed: R12.2, R21.1
unnamed: OC7.2 (C), R61.2
unnamed: OC7.6 (A2), R27.1
unnamed: OC8.2 (C), R64.2
unnamed: R15.1, R28.2
unnamed: R27.2, R28.1
unnamed: OC5.2 (C), R60.2
unnamed: OC6.2 (C), R65.2
unnamed: R16.2, R29.1
unnamed: OC7.4 (A1), R17.1, T7.G
unnamed: OC8.6 (A2), R16.1
unnamed: OC8.4 (A1), R18.1, T8.G
unnamed: R29.2, R30.1
unnamed: R37.2, R38.1
unnamed: OC5.4 (A1), R19.1, T5.G
unnamed: OC6.4 (A1), R20.1, T6.G
unnamed: C5.1, R21.2
unnamed: OC4.6 (A2), R4.1
unnamed: C8.1, R32.2
unnamed: R24.2, R32.1
unnamed: R24.1, R31.2
unnamed: R4.2, R35.1
unnamed: R35.2, R36.1
unnamed: OC6.6 (A2), R33.1
unnamed: R14.1, R33.2
unnamed: R14.2, R34.1
unnamed: R39.2, R40.1
unnamed: C1.1, R41.2
unnamed: R40.2, R41.1
unnamed: C4.1, R44.2
unnamed: R43.2, R44.1
unnamed: R42.2, R43.1
unnamed: R47.2, R48.1
unnamed: R13.2, R49.1
unnamed: R6.2, R47.1
unnamed: R2.2, R45.1
unnamed: R22.2, R51.1
unnamed: R10.2, R11.1
unnamed: C3.1, R56.1
unnamed: R53.2, R56.2
unnamed: C2.1, R55.1
unnamed: R51.2, R55.2
unnamed: C6.1, R54.1
unnamed: R11.2, R54.2
unnamed: LED1.A, R57.2
OUT1: JP1.3, R63.1
OUT2: JP1.5, R67.1
OUT3: JP1.7, R62.1
OUT4: JP1.9, R66.1
OUT5: JP1.4, R60.1
OUT6: JP1.6, R65.1
OUT7: JP1.8, R61.1
OUT8: JP1.10, R64.1

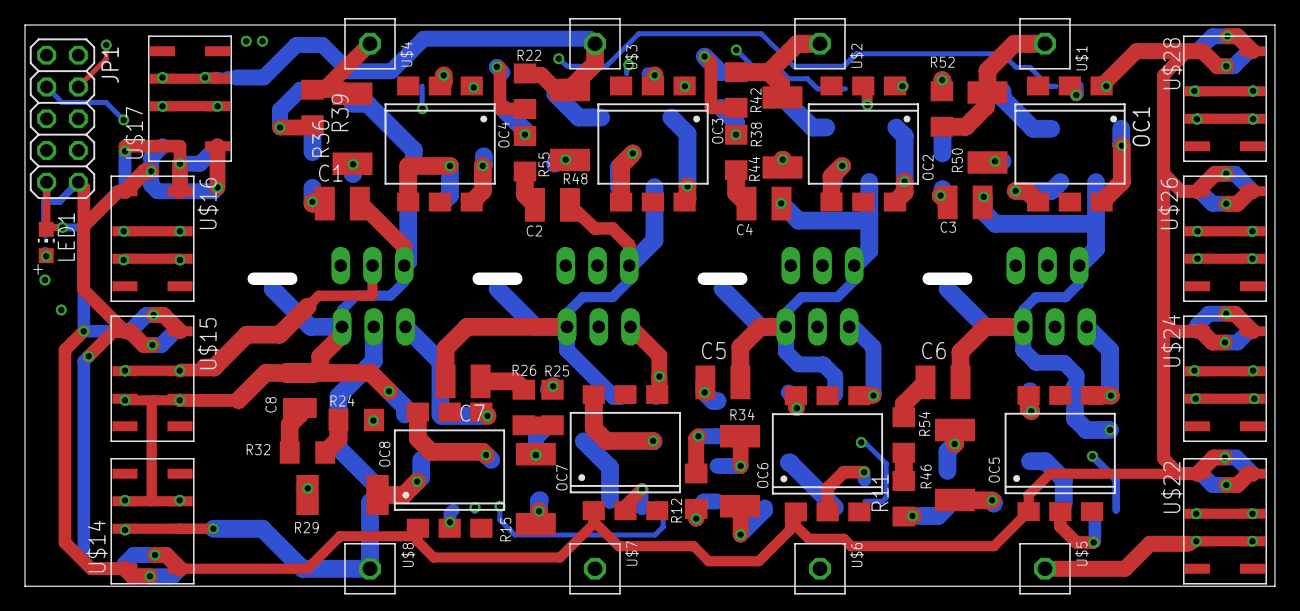
[picture p24: board mcb-enhancer-v5.brd from above]

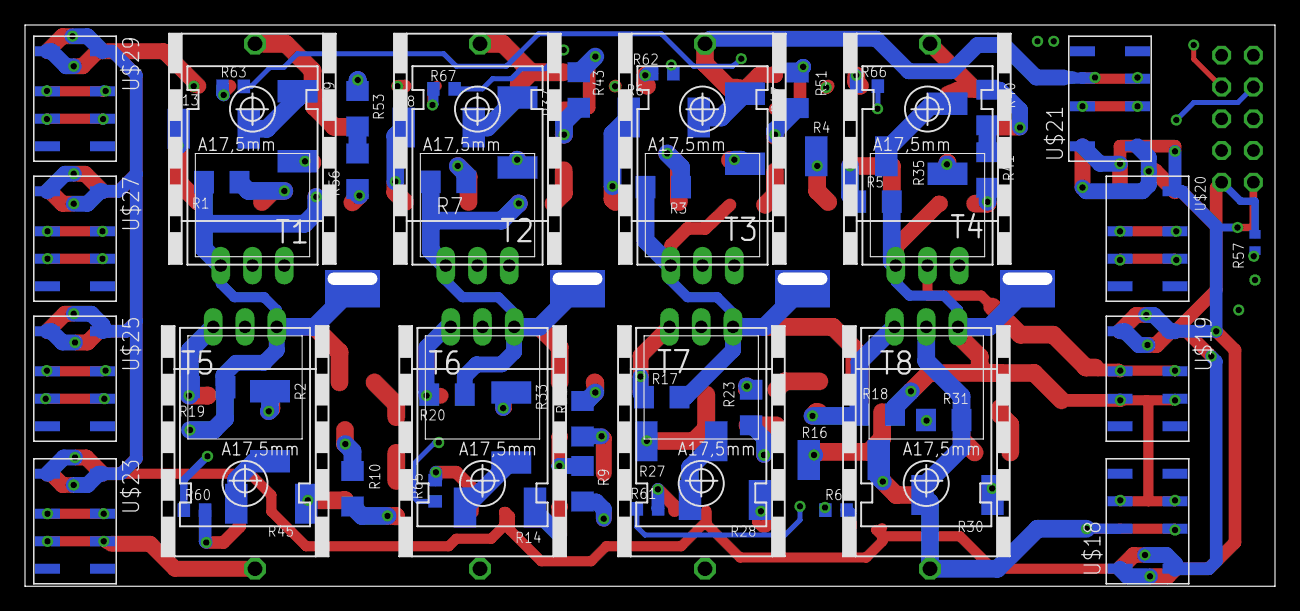
[picture p25: board mcb-enhancer-v5.brd from below]

Board: 4 copper layers, 100.0 x 44.9 mm, 127 parts (72 on the bottom side), 87 nets.
