bontorhumala/amelia-girl/mcb-enhancer/mcb-enhancer.brd

## EAGLE design mcb-enhancer/mcb-enhancer.brd (2015-07-24, an earlier design)

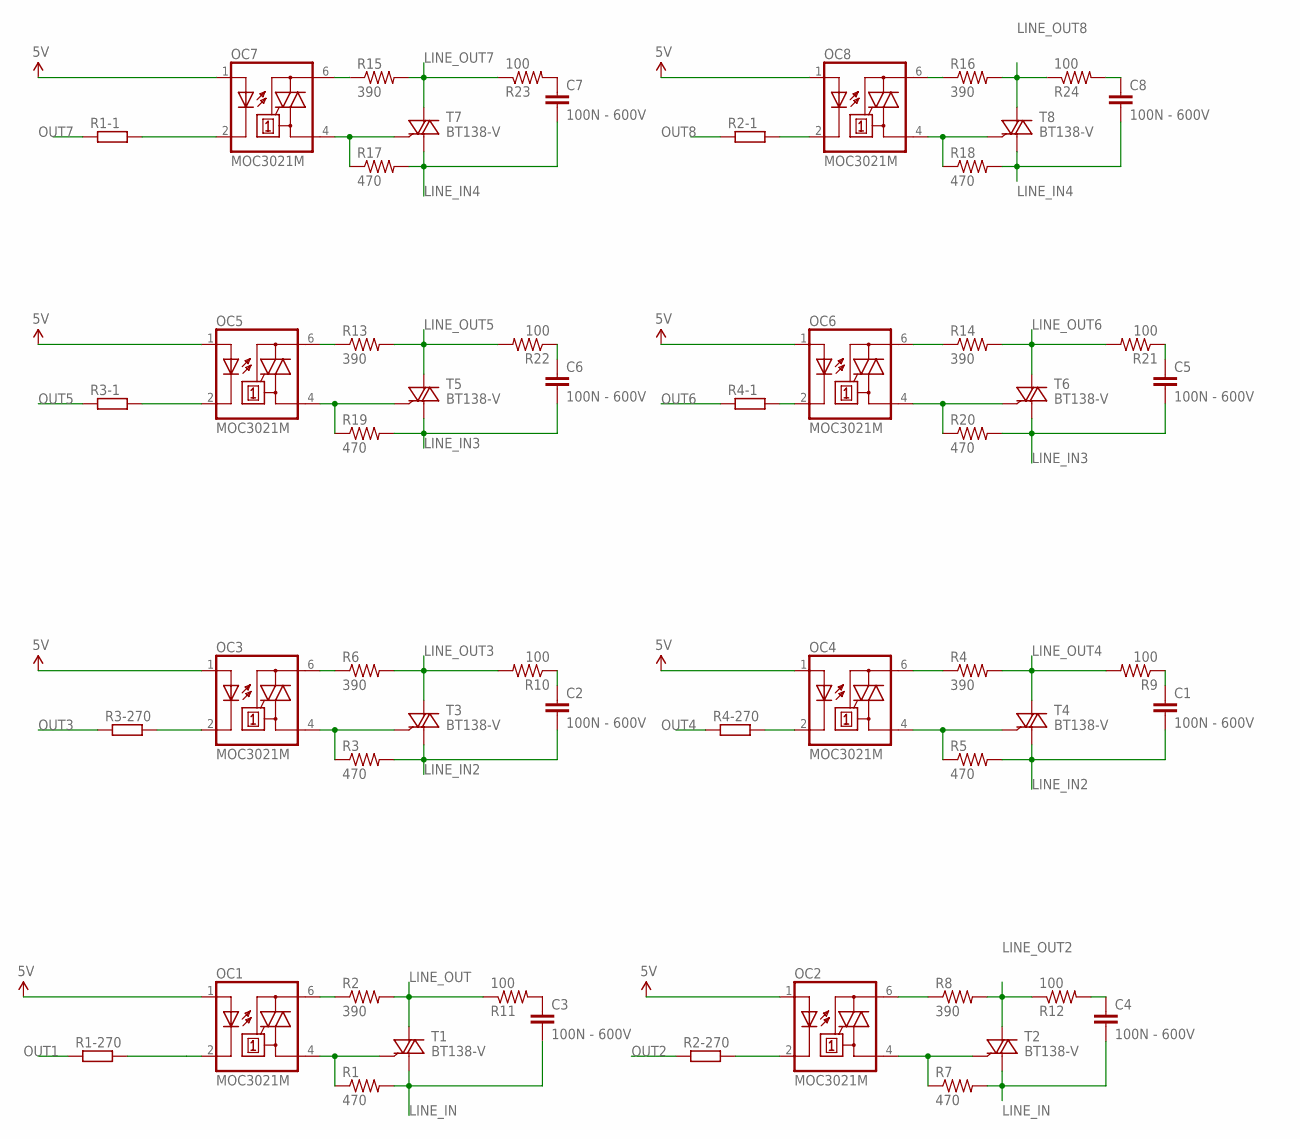
[picture p32: schematic mcb-enhancer.sch]

Parts:
C1, C2, C3, C4, C5, C6, C7, C8: 100N - 600V; C050-030X075
OC1, OC2, OC3, OC4, OC5, OC6, OC7, OC8: MOC3021M; DIL06
R1, R3, R5, R7, R17, R18, R19, R20: 470; 0207/7
R1-1, R1-270, R2-1, R2-270, R3-1, R3-270, R4-1, R4-270: R-EU_0309/V; 0309V
R2, R4, R6, R8, R13, R14, R15, R16: 390; 0207/7
R9, R10, R11, R12, R21, R22, R23, R24: 100; 0207/7
T1, T2, T3, T4, T5, T6, T7, T8: BT138-V; TO220BV

Connections:
5V: OC1.1 (A), OC2.1 (A), OC3.1 (A), OC4.1 (A), OC5.1 (A), OC6.1 (A), OC7.1 (A), OC8.1 (A)
LINE_IN: C3.2, C4.2, R1.2, R7.2, T1.T1 (A1), T2.T1 (A1)
LINE_IN2: C1.2, C2.2, R3.2, R5.2, T3.T1 (A1), T4.T1 (A1)
LINE_IN3: C5.2, C6.2, R19.2, R20.2, T5.T1 (A1), T6.T1 (A1)
LINE_IN4: C7.2, C8.2, R17.2, R18.2, T7.T1 (A1), T8.T1 (A1)
LINE_OUT: R2.2, R11.1, T1.T2 (A2)
LINE_OUT2: R8.2, R12.1, T2.T2 (A2)
LINE_OUT3: R6.2, R10.2, T3.T2 (A2)
LINE_OUT4: R4.2, R9.2, T4.T2 (A2)
LINE_OUT5: R13.2, R22.2, T5.T2 (A2)
LINE_OUT6: R14.2, R21.2, T6.T2 (A2)
LINE_OUT7: R15.2, R23.1, T7.T2 (A2)
LINE_OUT8: R16.2, R24.1, T8.T2 (A2)
unnamed: OC1.6 (A2), R2.1
unnamed: OC4.6 (A2), R4.1
unnamed: OC3.4 (A1), R3.1, T3.G
unnamed: OC3.6 (A2), R6.1
unnamed: OC4.4 (A1), R5.1, T4.G
unnamed: C1.1, R9.1
unnamed: C2.1, R10.1
unnamed: C3.1, R11.2
unnamed: OC1.4 (A1), R1.1, T1.G
unnamed: OC2.6 (A2), R8.1
unnamed: OC2.4 (A1), R7.1, T2.G
unnamed: OC5.6 (A2), R13.1
unnamed: OC2.2 (C), R2-270.2
unnamed: OC3.2 (C), R3-270.2
unnamed: OC4.2 (C), R4-270.2
unnamed: C4.1, R12.2
unnamed: OC7.2 (C), R1-1.2
unnamed: OC8.2 (C), R2-1.2
unnamed: OC5.2 (C), R3-1.2
unnamed: OC6.2 (C), R4-1.2
unnamed: OC7.4 (A1), R17.1, T7.G
unnamed: OC8.6 (A2), R16.1
unnamed: OC8.4 (A1), R18.1, T8.G
unnamed: OC7.6 (A2), R15.1
unnamed: OC6.6 (A2), R14.1
unnamed: OC5.4 (A1), R19.1, T5.G
unnamed: OC6.4 (A1), R20.1, T6.G
unnamed: C5.1, R21.1
unnamed: C6.1, R22.1
unnamed: C7.1, R23.2
unnamed: C8.1, R24.2
OUT1: R1-270.1
OUT2: R2-270.1
OUT3: R3-270.1
OUT4: R4-270.1
OUT5: R3-1.1
OUT6: R4-1.1
OUT7: R1-1.1
OUT8: R2-1.1

Board: 2 copper layers, 56 parts (0 on the bottom side), 44 nets, no tracks yet.
