bontorhumala/amelia-girl/6lowPan/bontor_mbed_lowpan_rev_a.brd

## EAGLE design 6lowPan/bontor_mbed_lowpan_rev_a.brd (2015-05-15, an earlier design)

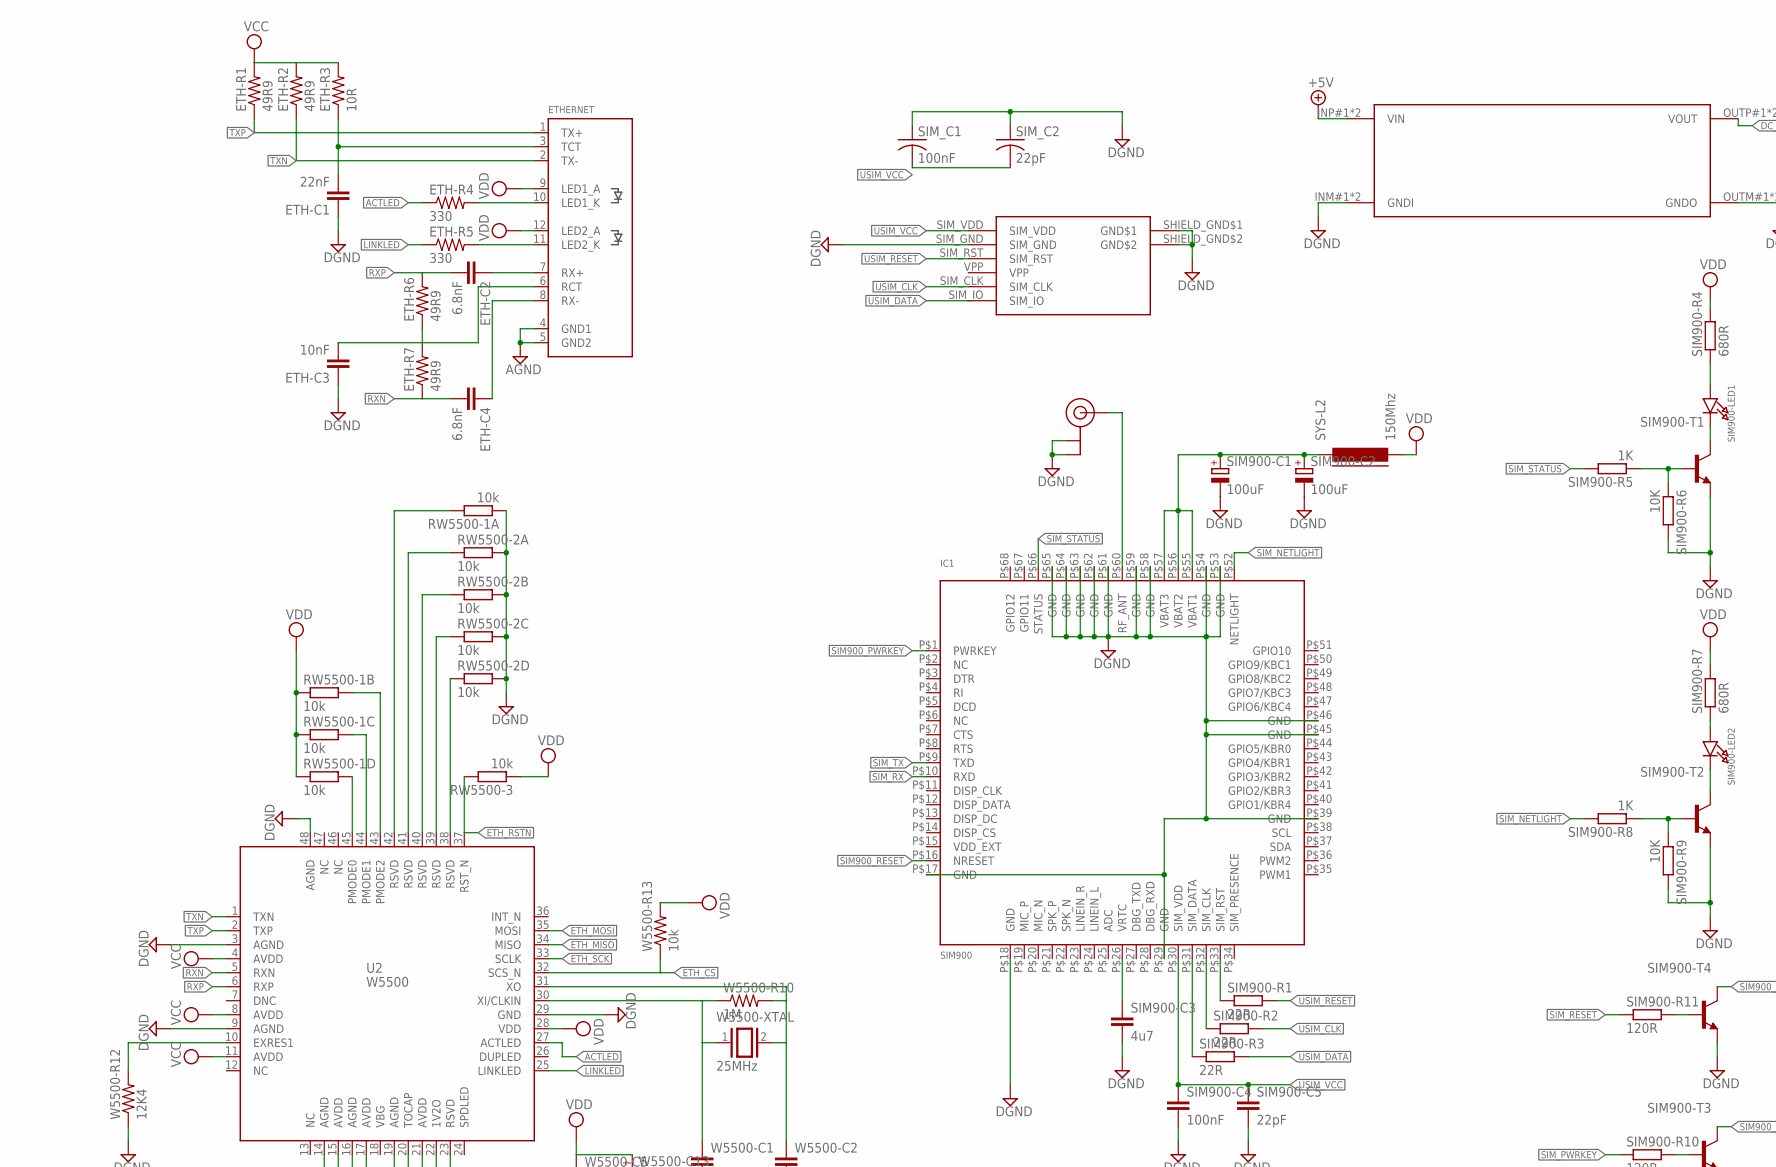
[picture p33: schematic bontor_mbed_lowpan_rev_a.sch, part in row 1, column 1]

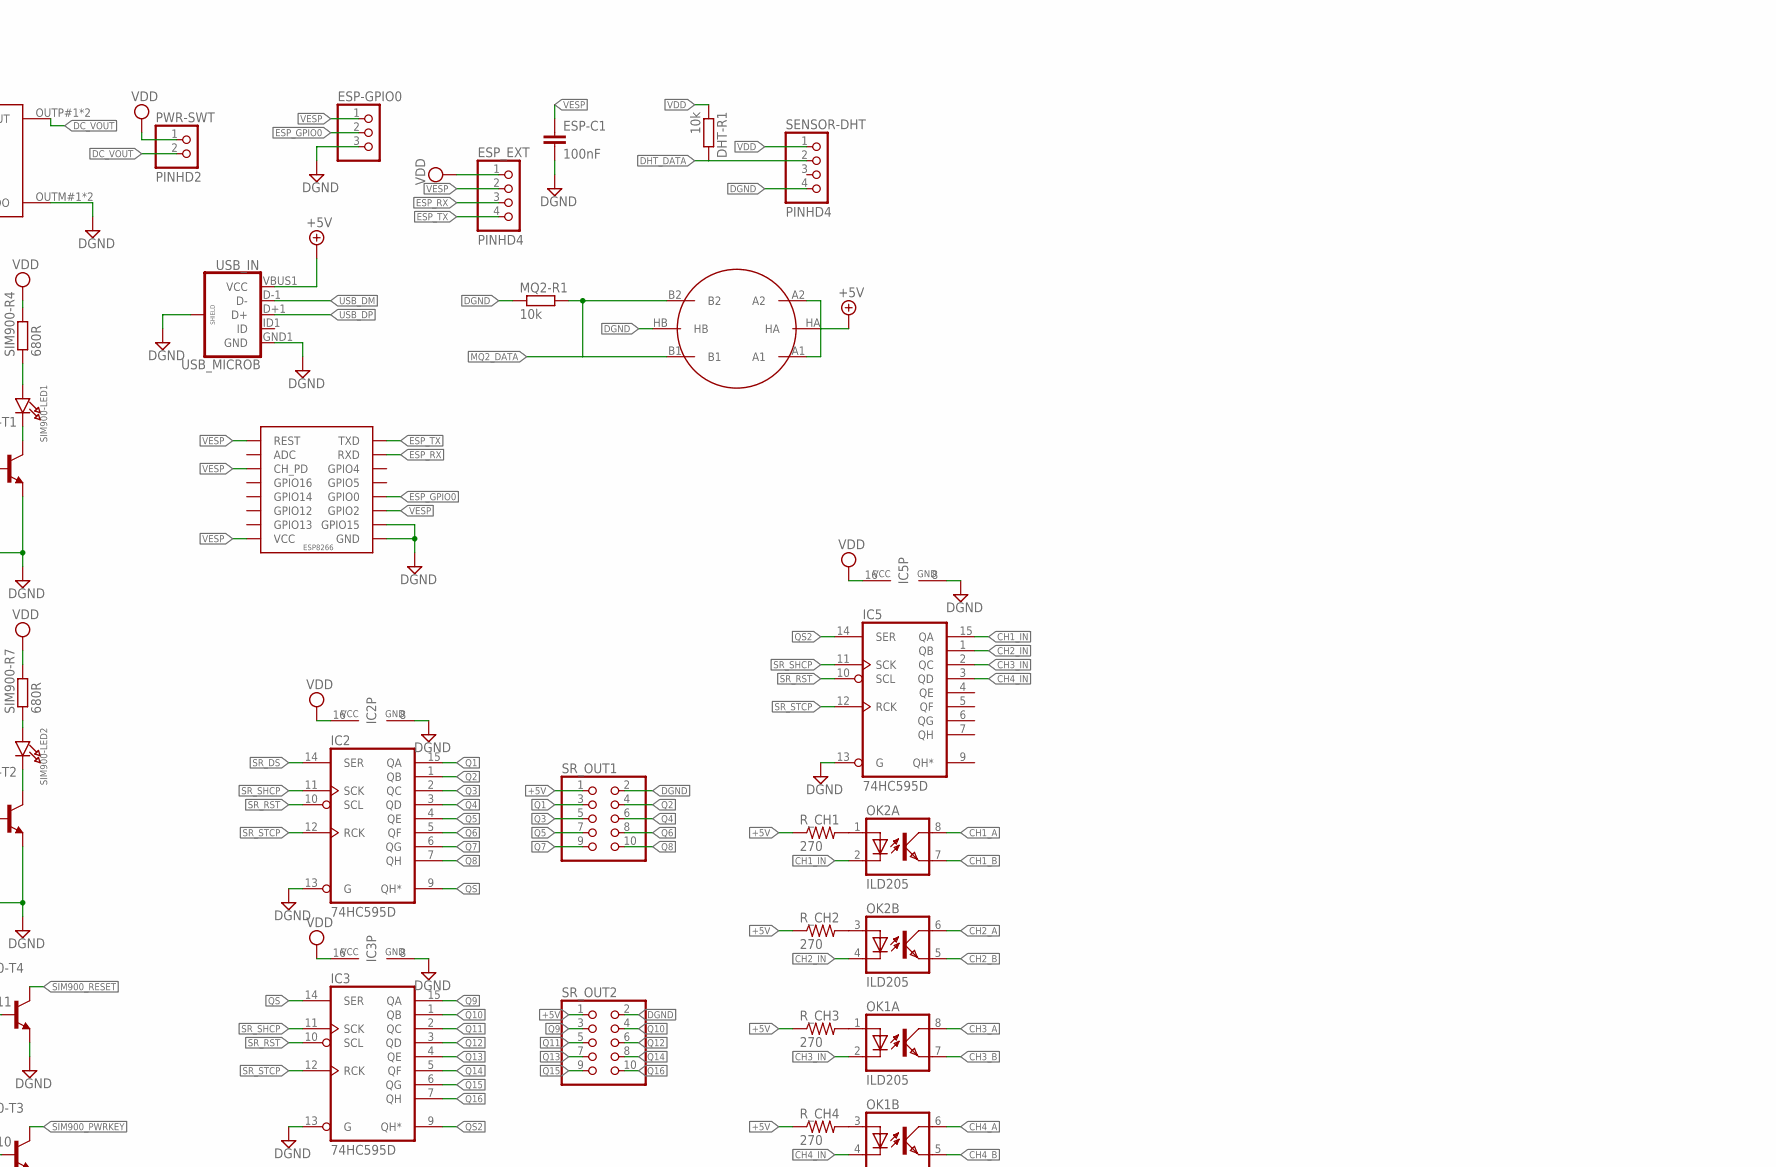
[picture p34: schematic bontor_mbed_lowpan_rev_a.sch, part in row 1, column 2]

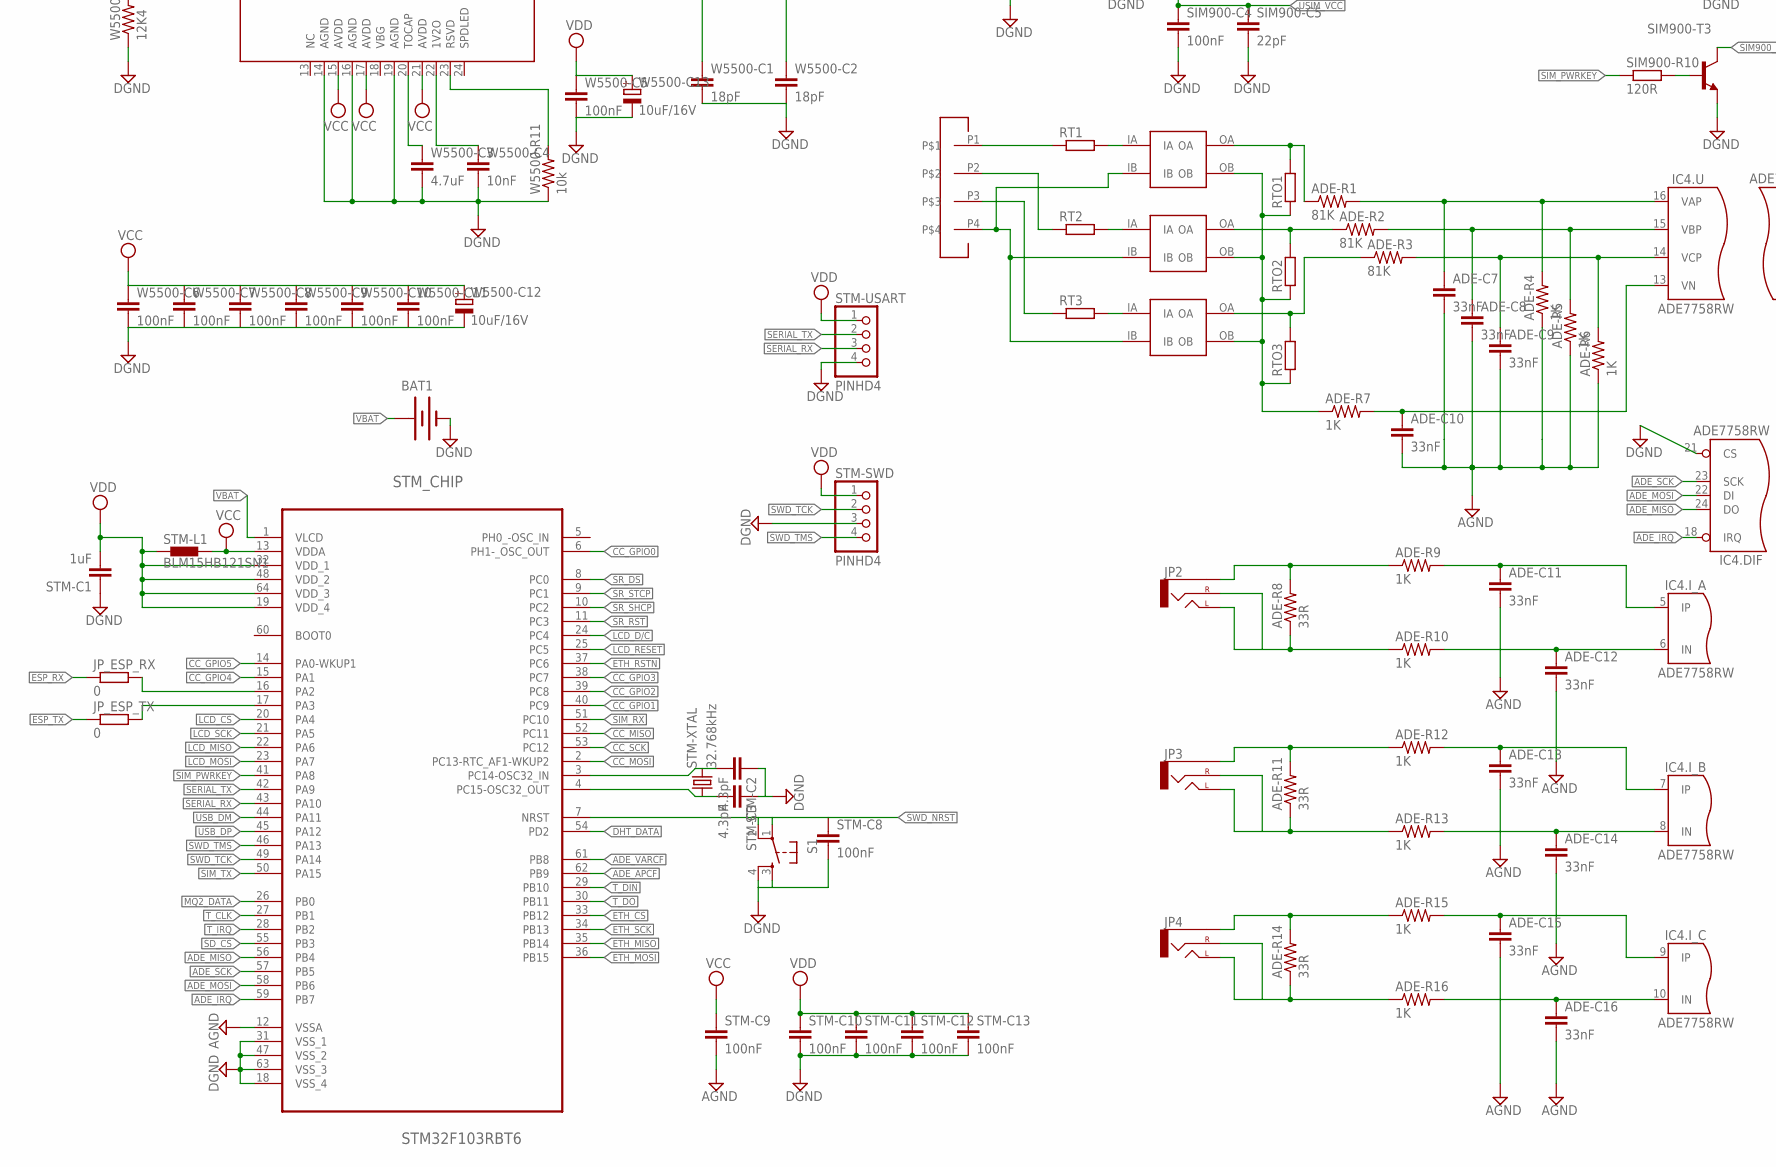
[picture p35: schematic bontor_mbed_lowpan_rev_a.sch, part in row 2, column 1]

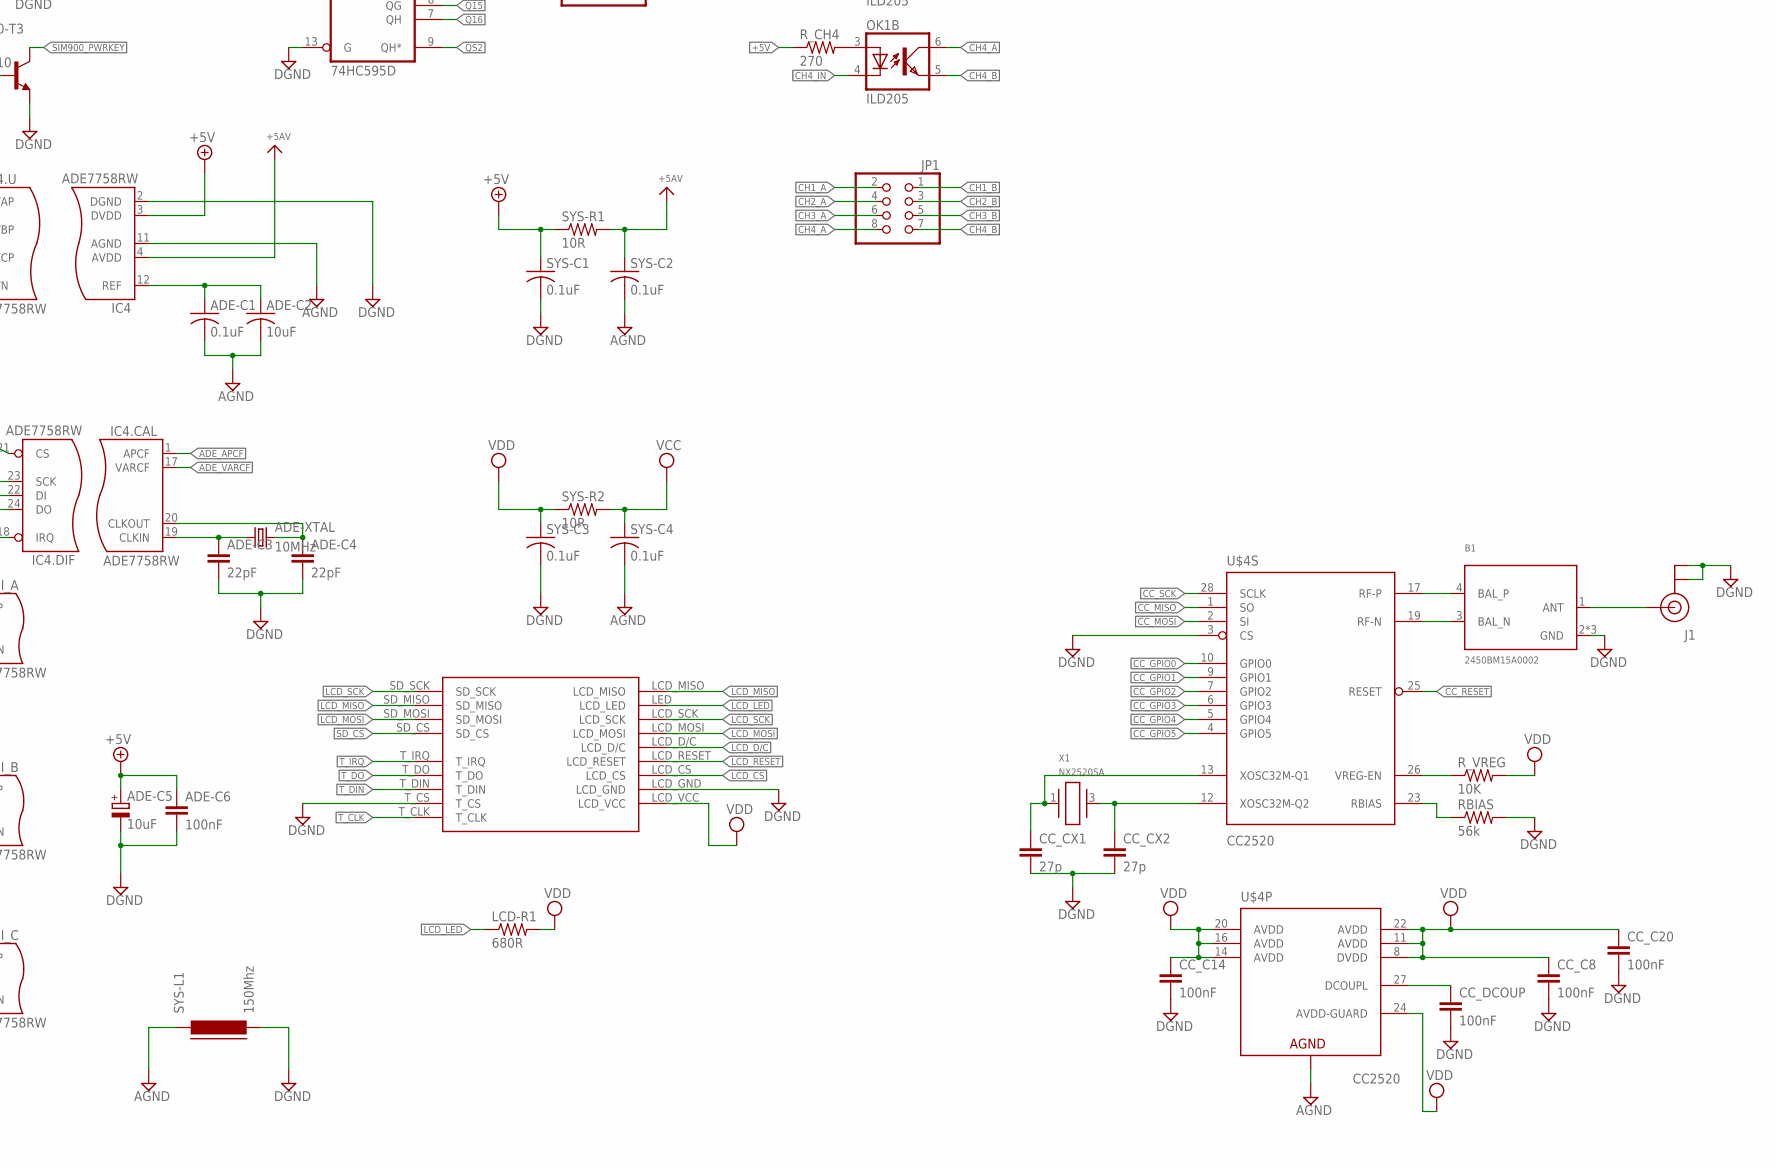
[picture p36: schematic bontor_mbed_lowpan_rev_a.sch, part in row 2, column 2]

Parts:
ADE-C1: 0.1uF; C0603@1
ADE-C2: 10uF; C0805K
ADE-C3, ADE-C4: 22pF; C0603
ADE-C5: 10uF; 153CLV-0605
ADE-C6: 100nF; C0603
ADE-C7, ADE-C8, ADE-C9, ADE-C10, ADE-C11, ADE-C12, ADE-C13, ADE-C14, ADE-C15, ADE-C16: 33nF; 0603-CAP
ADE-R1, ADE-R2, ADE-R3: 81K; 0603-RES
ADE-R4, ADE-R5, ADE-R6, ADE-R7, ADE-R9, ADE-R10, ADE-R12, ADE-R13, ADE-R15, ADE-R16: 1K; 0603-RES
ADE-R8, ADE-R11, ADE-R14: 33R; 0603-RES
ADE-XTAL: 10MHz; HC49US
B1: 2450BM15A0002; 2450BM
BAT1: BATTERY12MM; BATTCON_12MM
CC_C8, CC_C14, CC_C20: 100nF; C0402
CC_CX1, CC_CX2: 27p; C0201
CC_DCOUP: 100nF; C0402
DCDC-3.5V: DCDCMODULE_SMALL; DCDCMODULE-SMALL
DHT-R1: 10k; R0603
ESP-C1: 100nF; C0603
ESP-GPIO0: PINHD-1X3; 1X03
ESP_EXT: PINHD4
ETH-C1: 22nF; C0603
ETH-C2, ETH-C4: 6.8nF; C0603
ETH-C3: 10nF; C0603
ETH-R1, ETH-R2, ETH-R6, ETH-R7: 49R9; R0603
ETH-R3: 10R; R0603
ETH-R4, ETH-R5: 330; R0603
ETHERNET: RJ45J0026D21BNL; RJ45_PULSEJACK
IC1: SIM900; SIM900_SMT
IC2, IC3, IC5: 74HC595D; SO16
IC4: ADE7758RW; SOIC24
J1: U.FL
JP1: PINHD-2X4; 2X04
JP2, JP3, JP4: AUDIO-JACKSMD2; AUDIO-JACK-3.5MM-SMD
JP_ESP_RX: 0; R0201
JP_ESP_TX: 0; R0201
LCD-R1: 680R; 0603-RES
MQ2-R1: 10k; R0603
OK1, OK2: ILD205; SOIC08
PWR-SWT: PINHD2
RBIAS: 56k; 0402-RES
RT1, RT2, RT3: R-EU_0309/V; 0309V
RTO1, RTO2, RTO3: R-EU_0309/12; 0309/12
RW5500-1, RW5500-2: 10k; RN8P-4R-CRA06S
RW5500-3: 10k; R0603
R_CH1, R_CH2, R_CH3, R_CH4: 270; 0603-RES
R_VREG: 10K; 0402-RES
S1: TAC_SWITCHSMD; TACTILE-SWITCH-SMD
SENSOR-DHT: PINHD4
SENSOR-MQ2: METHANE_SENSOR; MQ-3
SIM900-C1, SIM900-C2: 100uF; 153CLV-0605
SIM900-C3: 4u7; C0603
SIM900-C4: 100nF; C0603
SIM900-C5: 22pF; C0603
SIM900-LED1, SIM900-LED2: LED0805_NOOUTLINE; CHIPLED_0805_NOOUTLINE
SIM900-R1, SIM900-R2, SIM900-R3: 22R; R0603
SIM900-R4, SIM900-R7: 680R; R0603
SIM900-R5, SIM900-R8: 1K; R0603
SIM900-R6, SIM900-R9: 10K; R0603
SIM900-R10, SIM900-R11: 120R; R0603
SIM900-T1, SIM900-T2, SIM900-T3, SIM900-T4: MMBT2222ALT1-NPN-SOT23-BEC; SOT23-BEC
SIM_C1: 100nF; C0603K
SIM_C2: 22pF; C0603K
SR_OUT1, SR_OUT2: PINHD-2X5/90; 2X05/90
STM-C1: 1uF; C0603
STM-C2, STM-C3: 4.3pF; C0603
STM-C8, STM-C9, STM-C10, STM-C11, STM-C12, STM-C13: 100nF; C0603
STM-L1: BLM15HB121SN1; 0402
STM-SWD: PINHD4
STM-USART: PINHD4
STM-XTAL: 32.768kHz; TC26H
STM_CHIP: STM32F103RBT6; QFP50P1200X1200X160-64N
SYS-C1, SYS-C2, SYS-C3, SYS-C4: 0.1uF; C0603@1
SYS-L1, SYS-L2: 150Mhz; FB805
SYS-R1, SYS-R2: 10R; 0603-RES
U2: W5500
U$4: CC2520; QFN50P500X500X100-29N
U$5: ESP8266WI12; WI12
U$7: U.FL
U$8: SIM_HOLDER; SIMHOLDER-PUSHPUSH
U$9, U$10, U$11: TRANSFORMER; TV16
U$12: TERMINAL_BLOCK; TERMINAL-RIGHT-ANGLE
U$13: LCD_2.4; LCD_TOUCH_2-4
USB_IN: USB_MICROB; USB-B-MICRO-SMD_V03
W5500-C1, W5500-C2: 18pF; C0603
W5500-C3: 4.7uF; C0603
W5500-C4: 10nF; C0603
W5500-C5, W5500-C6, W5500-C7, W5500-C8, W5500-C9, W5500-C10, W5500-C11: 100nF; C0603
W5500-C12, W5500-C13: 10uF/16V; 153CLV-0605
W5500-R10: 1M; R0603
W5500-R11, W5500-R13: 10k; R0603
W5500-R12: 12K4; R0805
W5500-XTAL: 25MHz; QS
X1: NX2520SA

Connections:
+5V: ADE-C5.+, ADE-C6.1, DCDC-3.5V.INP#1 (VIN), DCDC-3.5V.INP#2 (VIN), IC4.3 (DVDD), R_CH1.1, R_CH2.1, R_CH3.1, R_CH4.1, SENSOR-MQ2.A1, SENSOR-MQ2.A2, SENSOR-MQ2.HA, SR_OUT1.1, SR_OUT2.1, SYS-C1.1, SYS-R1.1, USB_IN.VBUS1 (VCC)
ACTLED: ETH-R4.1, U2.27 (ACTLED)
ADE_APCF: IC4.1 (APCF), STM_CHIP.62 (PB9)
ADE_IRQ: IC4.18 (IRQ), STM_CHIP.59 (PB7)
ADE_MISO: IC4.24 (DO), STM_CHIP.56 (PB4)
ADE_MOSI: IC4.22 (DI), STM_CHIP.58 (PB6)
ADE_SCK: IC4.23 (SCK), STM_CHIP.57 (PB5)
ADE_VARCF: IC4.17 (VARCF), STM_CHIP.61 (PB8)
AGND: ADE-C1.2, ADE-C2.2, ADE-C7.2, ADE-C8.2, ADE-C9.2, ADE-C10.2, ADE-C11.2, ADE-C12.2, ADE-C13.2, ADE-C14.2, ADE-C15.2, ADE-C16.2, ADE-R4.1, ADE-R5.1, ADE-R6.1, ETHERNET.4 (GND1), ETHERNET.5 (GND2), IC4.11 (AGND), STM-C9.2, STM_CHIP.12 (VSSA), SYS-C2.2, SYS-C4.2, SYS-L1.1, U$4.29 (AGND)
AVDD: IC4.4 (AVDD), SYS-C2.1, SYS-R1.2
CC_GPIO0: STM_CHIP.6 (PH1-_OSC_OUT), U$4.10 (GPIO0)
CC_GPIO1: STM_CHIP.40 (PC9), U$4.9 (GPIO1)
CC_GPIO2: STM_CHIP.39 (PC8), U$4.7 (GPIO2)
CC_GPIO3: STM_CHIP.38 (PC7), U$4.6 (GPIO3)
CC_GPIO4: STM_CHIP.15 (PA1), U$4.5 (GPIO4)
CC_GPIO5: STM_CHIP.14 (PA0-WKUP1), U$4.4 (GPIO5)
CC_MISO: STM_CHIP.52 (PC11), U$4.1 (SO)
CC_MOSI: STM_CHIP.2 (PC13-RTC_AF1-WKUP2), U$4.2 (SI)
CC_RESET: U$4.25 (RESET)
CC_SCK: STM_CHIP.53 (PC12), U$4.28 (SCLK)
CH1_A: JP1.2, OK2.8 (COL)
CH1_B: JP1.1, OK2.7 (EMIT)
CH1_IN: IC5.15 (QA), OK2.2 (C)
CH2_A: JP1.4, OK2.6 (COL)
CH2_B: JP1.3, OK2.5 (EMIT)
CH2_IN: IC5.1 (QB), OK2.4 (C)
CH3_A: JP1.6, OK1.8 (COL)
CH3_B: JP1.5, OK1.7 (EMIT)
CH3_IN: IC5.2 (QC), OK1.2 (C)
CH4_A: JP1.8, OK1.6 (COL)
CH4_B: JP1.7, OK1.5 (EMIT)
CH4_IN: IC5.3 (QD), OK1.4 (C)
DC_VOUT: DCDC-3.5V.OUTP#1 (VOUT), DCDC-3.5V.OUTP#2 (VOUT), PWR-SWT.2
DGND: ADE-C3.2, ADE-C4.2, ADE-C5.-, ADE-C6.2, B1.2 (GND), B1.5 (GND), B1.6 (GND), BAT1.GND (-), CC_C8.2, CC_C14.2, CC_C20.2, CC_CX1.2, CC_CX2.2, CC_DCOUP.2, DCDC-3.5V.INM#1 (GNDI), DCDC-3.5V.INM#2 (GNDI), DCDC-3.5V.OUTM#1 (GNDO), DCDC-3.5V.OUTM#2 (GNDO), ESP-C1.2, ESP-GPIO0.3, ETH-C1.1, ETH-C3.1, IC1.P$17 (GND), IC1.P$18 (GND), IC1.P$29 (GND), IC1.P$39 (GND), IC1.P$45 (GND), IC1.P$46 (GND), IC1.P$53 (GND), IC1.P$54 (GND), IC1.P$58 (GND), IC1.P$59 (GND), IC1.P$61 (GND), IC1.P$62 (GND), IC1.P$63 (GND), IC1.P$64 (GND), IC1.P$65 (GND), IC2.8 (GND), IC2.13 (G), IC3.8 (GND), IC3.13 (G), IC4.2 (DGND), IC4.21 (CS), IC5.8 (GND), IC5.13 (G), J1.P$1 (GND), J1.P$2 (GND), MQ2-R1.1, RBIAS.2, RW5500-1.1, RW5500-2.5 (2), RW5500-2.6 (2), RW5500-2.7 (2), RW5500-2.8 (2), S1.3, S1.4, SENSOR-DHT.4, SENSOR-MQ2.HB, SIM900-C1.-, SIM900-C2.-, SIM900-C3.2, SIM900-C4.2, SIM900-C5.2, SIM900-R6.2, SIM900-R9.2, SIM900-T1.E, SIM900-T2.E, SIM900-T3.E, SIM900-T4.E, SIM_C1.1, SIM_C2.1, SR_OUT1.2, SR_OUT2.2, STM-C1.1, STM-C2.1, STM-C3.1, STM-C8.2, STM-C10.2, STM-C11.2, STM-C12.2, STM-C13.2, STM-SWD.3, STM-USART.4, STM_CHIP.18 (VSS_4), STM_CHIP.31 (VSS_1), STM_CHIP.47 (VSS_2), STM_CHIP.63 (VSS_3), SYS-C1.2, SYS-C3.2, SYS-L1.2, U2.3 (AGND), U2.9 (AGND), U2.14 (AGND), U2.16 (AGND), U2.19 (AGND), U2.29 (GND), U2.48 (AGND), U$4.3 (CS), U$5.GND, U$5.GPIO15, U$7.P$1 (GND), U$7.P$2 (GND), U$8.SHIELD_GND$1 (GND$1), U$8.SHIELD_GND$2 (GND$2), U$8.SIM_GND, U$13.LCD_GND, U$13.T_CS, USB_IN.GND1 (GND), USB_IN.SHIELD1 (SHIELD), USB_IN.SHIELD2 (SHIELD), USB_IN.SHIELD3 (SHIELD), W5500-C1.2, W5500-C2.2, W5500-C3.2, W5500-C4.2, W5500-C5.2, W5500-C6.2, W5500-C7.2, W5500-C8.2, W5500-C9.2, W5500-C10.2, W5500-C11.2, W5500-C12.-, W5500-C13.-, W5500-R11.1, W5500-R12.1
DHT_DATA: DHT-R1.2, SENSOR-DHT.2, STM_CHIP.54 (PD2)
ESP_GPIO0: ESP-GPIO0.2, U$5.GPIO00 (GPIO0)
ESP_RX: ESP_EXT.3, JP_ESP_RX.1, U$5.RXD
ESP_TX: ESP_EXT.4, JP_ESP_TX.1, U$5.TXD
ETH_CS: STM_CHIP.33 (PB12), U2.32 (SCS_N), W5500-R13.1
ETH_MISO: STM_CHIP.35 (PB14), U2.34 (MISO)
ETH_MOSI: STM_CHIP.36 (PB15), U2.35 (MOSI)
ETH_RSTN: RW5500-3.2, STM_CHIP.37 (PC6), U2.37 (RST_N)
ETH_SCK: STM_CHIP.34 (PB13), U2.33 (SCLK)
GPIO11: IC1.P$67 (GPIO11)
GPIO12: IC1.P$68 (GPIO12)
IBN: ADE-R11.1, ADE-R13.1, JP3.RING (RIGHT), JP3.TIP (LEFT)
ICN: ADE-R14.1, ADE-R16.1, JP4.RING (RIGHT), JP4.TIP (LEFT)
LCD_CS: STM_CHIP.20 (PA4), U$13.LCD_CS
LCD_D/C: STM_CHIP.24 (PC4), U$13.LCD_D/C
LCD_LED: LCD-R1.1, U$13.LED (LCD_LED)
LCD_MISO: STM_CHIP.22 (PA6), U$13.LCD_MISO, U$13.SD_MISO
LCD_MOSI: STM_CHIP.23 (PA7), U$13.LCD_MOSI, U$13.SD_MOSI
LCD_RESET: STM_CHIP.25 (PC5), U$13.LCD_RESET
LCD_SCK: STM_CHIP.21 (PA5), U$13.LCD_SCK, U$13.SD_SCK
LINKLED: ETH-R5.1, U2.25 (LINKLED)
MQ2_DATA: MQ2-R1.2, SENSOR-MQ2.B1, SENSOR-MQ2.B2, STM_CHIP.26 (PB0)
unnamed: STM-C2.2, STM-XTAL.2, STM_CHIP.3 (PC14-OSC32_IN)
unnamed: STM-C3.2, STM-XTAL.1, STM_CHIP.4 (PC15-OSC32_OUT)
unnamed: IC1.P$31 (SIM_DATA), SIM900-R3.1
unnamed: OK2.1 (A), R_CH1.2
unnamed: OK2.3 (A), R_CH2.2
unnamed: OK1.1 (A), R_CH3.2
unnamed: IC1.P$32 (SIM_CLK), SIM900-R2.1
unnamed: R_VREG.1, U$4.26 (VREG-EN)
unnamed: ADE-C9.1, ADE-R3.2, ADE-R6.2, IC4.14 (VCP)
unnamed: ETH-R4.2, ETHERNET.10 (LED1_K)
unnamed: ETH-R5.2, ETHERNET.11 (LED2_K)
unnamed: IC1.P$33 (SIM_RST), SIM900-R1.1
unnamed: IC1.P$26 (VRTC), SIM900-C3.1
unnamed: IC1.P$60 (RF_ANT), U$7.P$3 (SIGNAL)
unnamed: SIM900-LED1.A, SIM900-R4.1
unnamed: SIM900-LED1.C, SIM900-T1.C
unnamed: SIM900-R5.1, SIM900-R6.1, SIM900-T1.B
unnamed: SIM900-LED2.A, SIM900-R7.1
unnamed: SIM900-LED2.C, SIM900-T2.C
unnamed: SIM900-R8.1, SIM900-R9.1, SIM900-T2.B
unnamed: ETH-C2.1, ETHERNET.7 (RX+)
unnamed: ETH-C1.2, ETH-R3.1, ETHERNET.3 (TCT)
unnamed: ADE-C15.1, ADE-R15.2, IC4.9 (IP)
unnamed: ADE-R11.2, ADE-R12.1, JP3.SLEEVE
unnamed: ETH-C4.1, ETHERNET.8 (RX-)
unnamed: ADE-C11.1, ADE-R9.2, IC4.5 (IP)
unnamed: ADE-C12.1, ADE-R10.2, IC4.6 (IN)
unnamed: ETH-C3.2, ETH-R6.1, ETH-R7.2, ETHERNET.6 (RCT)
unnamed: ADE-C14.1, ADE-R13.2, IC4.8 (IN)
unnamed: ADE-C13.1, ADE-R12.2, IC4.7 (IP)
unnamed: ADE-C1.1, ADE-C2.1, IC4.12 (REF)
unnamed: ADE-C3.1, ADE-XTAL.1, IC4.19 (CLKIN)
unnamed: ADE-C4.1, ADE-XTAL.2, IC4.20 (CLKOUT)
unnamed: ADE-C10.1, ADE-R7.2, IC4.13 (VN)
unnamed: ADE-R2.1, RTO2.2, U$10.OA
unnamed: ADE-C8.1, ADE-R2.2, ADE-R5.2, IC4.15 (VBP)
unnamed: U2.20 (TOCAP), W5500-C3.1
unnamed: ADE-R8.2, ADE-R9.1, JP2.SLEEVE
unnamed: ADE-C16.1, ADE-R16.2, IC4.10 (IN)
unnamed: U2.22 (1V2O), W5500-C4.1
unnamed: U2.23 (RSVD), W5500-R11.2
unnamed: CC_DCOUP.1, U$4.27 (DCOUPL)
unnamed: SIM900-R10.2, SIM900-T3.B
unnamed: SIM900-R11.2, SIM900-T4.B
unnamed: OK1.3 (A), R_CH4.2
unnamed: ADE-R8.1, ADE-R10.1, JP2.RING (RIGHT), JP2.TIP (LEFT)
unnamed: ADE-R14.2, ADE-R15.1, JP4.SLEEVE
unnamed: U2.31 (XO), W5500-C2.1, W5500-R10.2, W5500-XTAL.2
unnamed: U2.10 (EXRES1), W5500-R12.2
unnamed: ADE-C7.1, ADE-R1.2, ADE-R4.2, IC4.16 (VAP)
unnamed: ADE-R1.1, RTO1.2, U$9.OA
unnamed: ADE-R7.1, RTO1.1, RTO2.1, RTO3.1, U$9.OB, U$10.OB, U$11.OB
unnamed: RW5500-2.4 (1), U2.38 (RSVD)
unnamed: RW5500-2.3 (1), U2.39 (RSVD)
unnamed: RW5500-2.2 (1), U2.40 (RSVD)
unnamed: RW5500-2.1, U2.41 (RSVD)
unnamed: RW5500-1.8 (2), U2.42 (RSVD)
unnamed: RW5500-1.7 (2), U2.43 (PMODE2)
unnamed: RW5500-1.6 (2), U2.44 (PMODE1)
unnamed: RW5500-1.5 (2), U2.45 (PMODE0)
unnamed: ADE-R3.1, RTO3.2, U$11.OA
unnamed: U2.30 (XI/CLKIN), W5500-C1.1, W5500-R10.1, W5500-XTAL.1
unnamed: IC1.P$55 (VBAT1), IC1.P$56 (VBAT2), IC1.P$57 (VBAT3), SIM900-C1.+, SIM900-C2.+, SYS-L2.1
unnamed: CC_CX1.1, U$4.13 (XOSC32M-Q1), X1.1
unnamed: CC_CX2.1, U$4.12 (XOSC32M-Q2), X1.3 (2)
unnamed: JP_ESP_RX.2, STM_CHIP.16 (PA2)
unnamed: JP_ESP_TX.2, STM_CHIP.17 (PA3)
unnamed: RT3.2, U$11.IA
unnamed: RT2.2, U$10.IA
unnamed: RT1.2, U$9.IA
unnamed: RBIAS.1, U$4.23 (RBIAS)
unnamed: U$9.IB, U$10.IB, U$11.IB, U$12.P4
unnamed: B1.4 (BAL_P), U$4.17 (RF-P)
unnamed: RT1.1, U$12.P1
unnamed: RT2.1, U$12.P2
unnamed: RT3.1, U$12.P3
unnamed: B1.3 (BAL_N), U$4.19 (RF-N)
unnamed: B1.1 (ANT), J1.P$3 (SIGNAL)
Q1: IC2.15 (QA), SR_OUT1.3
Q2: IC2.1 (QB), SR_OUT1.4
Q3: IC2.2 (QC), SR_OUT1.5
Q4: IC2.3 (QD), SR_OUT1.6
Q5: IC2.4 (QE), SR_OUT1.7
Q6: IC2.5 (QF), SR_OUT1.8
Q7: IC2.6 (QG), SR_OUT1.9
Q8: IC2.7 (QH), SR_OUT1.10
Q9: IC3.15 (QA), SR_OUT2.3
Q10: IC3.1 (QB), SR_OUT2.4
Q11: IC3.2 (QC), SR_OUT2.5
Q12: IC3.3 (QD), SR_OUT2.6
Q13: IC3.4 (QE), SR_OUT2.7
Q14: IC3.5 (QF), SR_OUT2.8
Q15: IC3.6 (QG), SR_OUT2.9
Q16: IC3.7 (QH), SR_OUT2.10
QS: IC2.9 (QH*), IC3.14 (SER)
QS2: IC3.9 (QH*), IC5.14 (SER)
RXN: ETH-C4.2, ETH-R7.1, U2.5 (RXN)
RXP: ETH-C2.2, ETH-R6.2, U2.6 (RXP)
SD_CS: STM_CHIP.55 (PB3), U$13.SD_CS
SERIAL_RX: STM-USART.3, STM_CHIP.43 (PA10)
SERIAL_TX: STM-USART.2, STM_CHIP.42 (PA9)
SIM900_PWRKEY: IC1.P$1 (PWRKEY), SIM900-T3.C
SIM900_RESET: IC1.P$16 (NRESET), SIM900-T4.C
SIM_NETLIGHT: IC1.P$52 (NETLIGHT), SIM900-R8.2
SIM_PWRKEY: SIM900-R10.1, STM_CHIP.41 (PA8)
SIM_RESET: SIM900-R11.1
SIM_RX: IC1.P$10 (RXD), STM_CHIP.51 (PC10)
SIM_STATUS: IC1.P$66 (STATUS), SIM900-R5.2
SIM_TX: IC1.P$9 (TXD), STM_CHIP.50 (PA15)
SR_DS: IC2.14 (SER), STM_CHIP.8 (PC0)
SR_RST: IC2.10 (SCL), IC3.10 (SCL), IC5.10 (SCL), STM_CHIP.11 (PC3)
SR_SHCP: IC2.11 (SCK), IC3.11 (SCK), IC5.11 (SCK), STM_CHIP.10 (PC2)
SR_STCP: IC2.12 (RCK), IC3.12 (RCK), IC5.12 (RCK), STM_CHIP.9 (PC1)
SWD_NRST: S1.1, S1.2, STM-C8.1, STM_CHIP.7 (NRST)
SWD_TCK: STM-SWD.2, STM_CHIP.49 (PA14)
SWD_TMS: STM-SWD.4, STM_CHIP.46 (PA13)
TXN: ETH-R2.1, ETHERNET.2 (TX-), U2.1 (TXN)
TXP: ETH-R1.1, ETHERNET.1 (TX+), U2.2 (TXP)
T_CLK: STM_CHIP.27 (PB1), U$13.T_CLK
T_DIN: STM_CHIP.29 (PB10), U$13.T_DIN
T_DO: STM_CHIP.30 (PB11), U$13.T_DO
T_IRQ: STM_CHIP.28 (PB2), U$13.T_IRQ
USB_DM: STM_CHIP.44 (PA11), USB_IN.D-1 (D-)
USB_DP: STM_CHIP.45 (PA12), USB_IN.D+1 (D+)
USIM_CLK: SIM900-R2.2, U$8.SIM_CLK
USIM_DATA: SIM900-R3.2, U$8.SIM_IO
USIM_RESET: SIM900-R1.2, U$8.SIM_RST
USIM_VCC: IC1.P$30 (SIM_VDD), SIM900-C4.1, SIM900-C5.1, SIM_C1.2, SIM_C2.2, U$8.SIM_VDD
VBAT: BAT1.PWR@1 (+), STM_CHIP.1 (VLCD)
VCC: ETH-R1.2, ETH-R2.2, ETH-R3.2, STM-C9.1, STM-L1.2, STM_CHIP.13 (VDDA), SYS-C4.1, SYS-R2.2, U2.4 (AVDD), U2.8 (AVDD), U2.11 (AVDD), U2.15 (AVDD), U2.17 (AVDD), U2.21 (AVDD), W5500-C6.1, W5500-C7.1, W5500-C8.1, W5500-C9.1, W5500-C10.1, W5500-C11.1, W5500-C12.+
VDD: CC_C8.1, CC_C14.1, CC_C20.1, DHT-R1.1, ESP_EXT.1, ETHERNET.9 (LED1_A), ETHERNET.12 (LED2_A), IC2.16 (VCC), IC3.16 (VCC), IC5.16 (VCC), LCD-R1.2, PWR-SWT.1, RW5500-1.2 (1), RW5500-1.3 (1), RW5500-1.4 (1), RW5500-3.1, R_VREG.2, SENSOR-DHT.1, SIM900-R4.2, SIM900-R7.2, STM-C1.2, STM-C10.1, STM-C11.1, STM-C12.1, STM-C13.1, STM-L1.1, STM-SWD.1, STM-USART.1, STM_CHIP.19 (VDD_4), STM_CHIP.32 (VDD_1), STM_CHIP.48 (VDD_2), STM_CHIP.64 (VDD_3), SYS-C3.1, SYS-L2.2, SYS-R2.1, U2.28 (VDD), U$4.8 (DVDD), U$4.11 (AVDD), U$4.14 (AVDD), U$4.16 (AVDD), U$4.20 (AVDD), U$4.22 (AVDD), U$4.24 (AVDD-GUARD), U$13.LCD_VCC, W5500-C5.1, W5500-C13.+, W5500-R13.2
VESP: ESP-C1.1, ESP-GPIO0.1, ESP_EXT.2, U$5.CH_PD, U$5.GPIO02 (GPIO2), U$5.REST, U$5.VCC

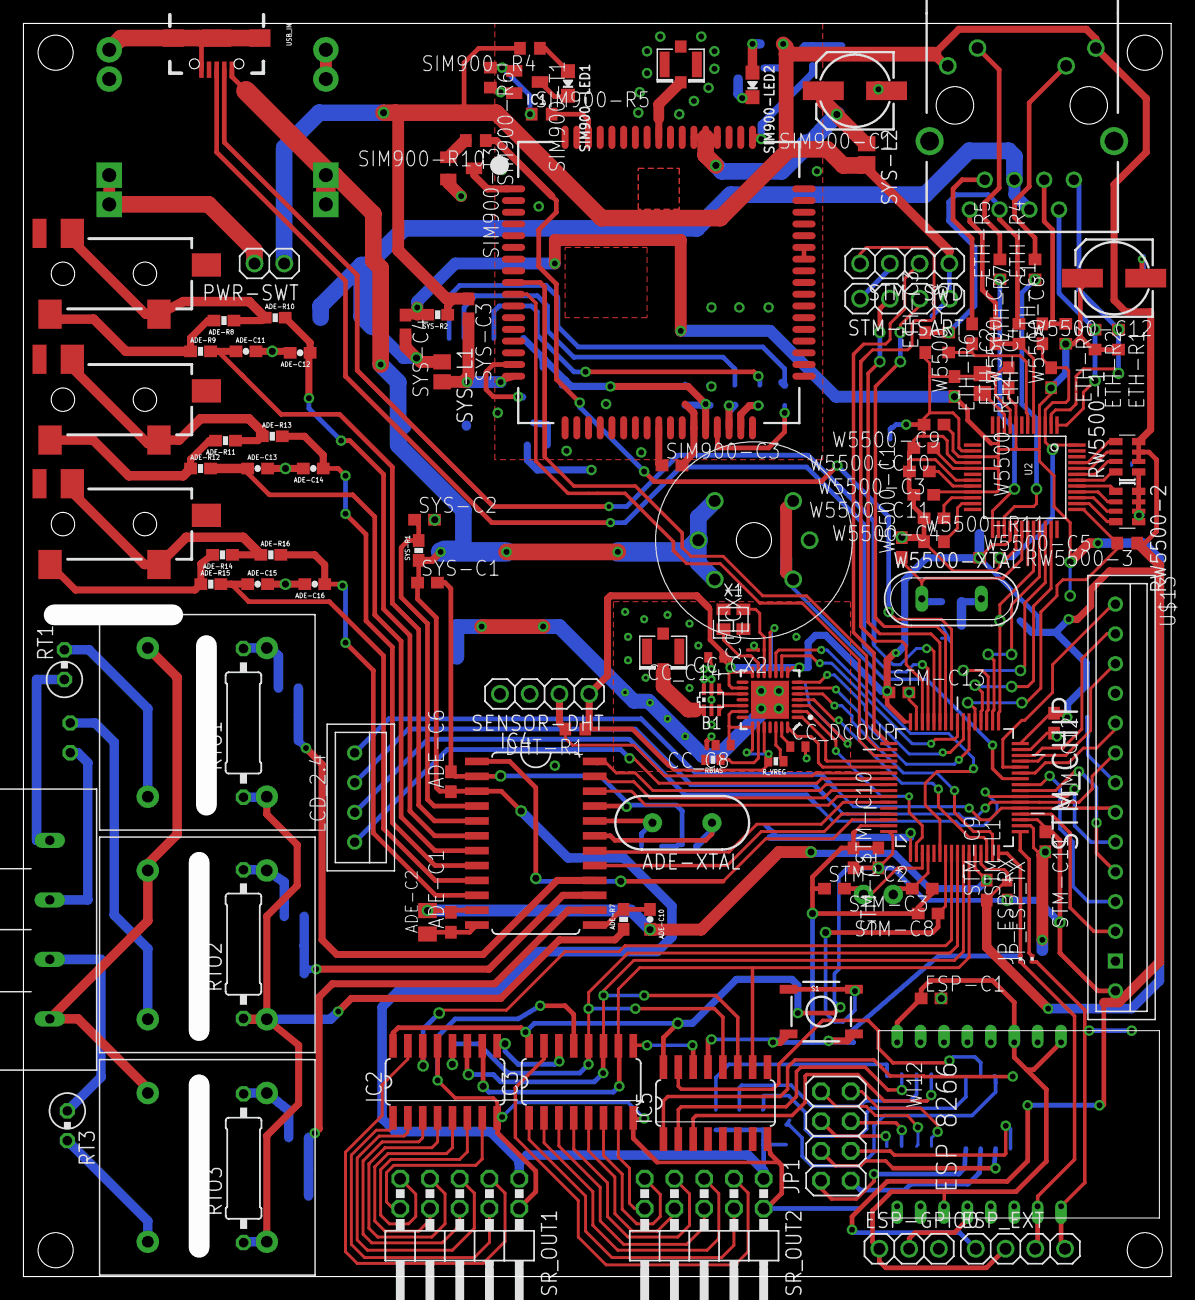
[picture p37: board bontor_mbed_lowpan_rev_a.brd from above]

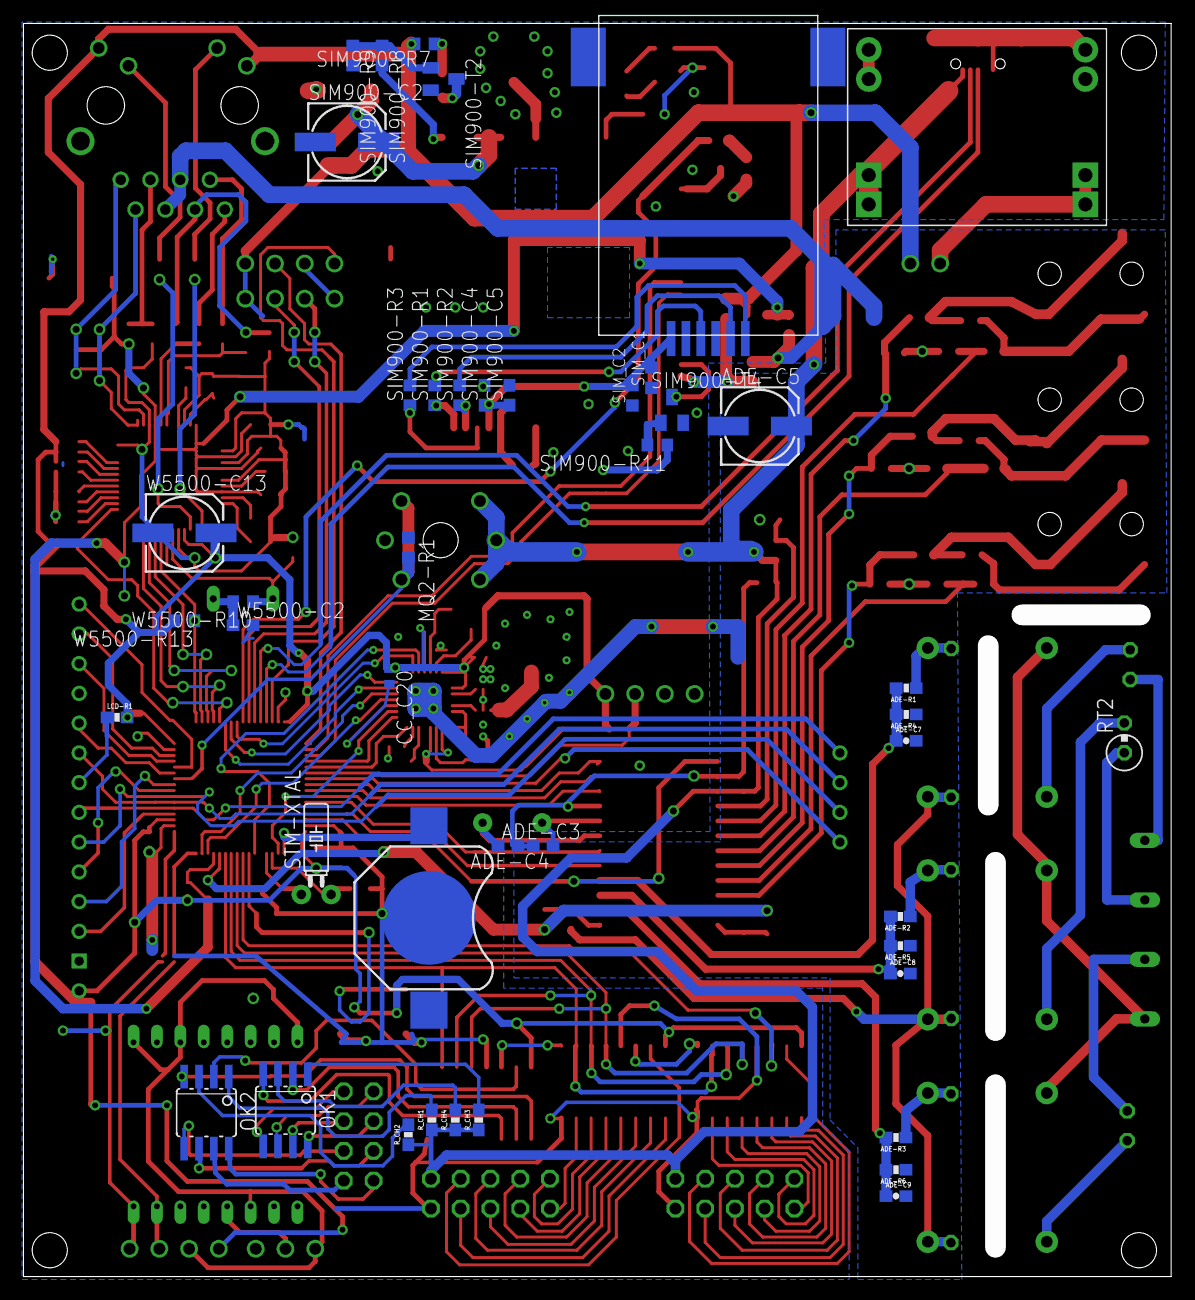
[picture p38: board bontor_mbed_lowpan_rev_a.brd from below]

Board: 2 copper layers, 98.0 x 107.0 mm, 171 parts (44 on the bottom side), 184 nets.
