bontorhumala/amelia-girl/(commit log)

2015-05-15 add gerber and BoM
    [EMMA-BoM.xlsx, bontor_mbed_lowpan_rev_d.brd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]
2015-05-19 added PCB models and revise PCB to move DC module on top
    [EMMA-BoM.xlsx, Emma_Finished.obj, Emma_Finished.stl, mbed-lowpan-BoM.xlsx]
2015-05-20 update all PCB design
    [bontor_mbed_lowpan_rev_d.brd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]
2015-05-26 adding designators and center components on its origin
    [bontor_mbed_lowpan_rev_d.brd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]
2015-05-27 update PCB and BoM to use vertical RJ11
    [bontor_mbed_lowpan_rev_e.brd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]
2015-05-27 update PCB and BoM and model to use vertical RJ11
2015-05-28 use RJ11 vertical connector
    [bontor_mbed_lowpan_rev_f.brd, bontor_mbed_lowpan_rev_f.sch]
2015-06-09 update silkscreen and delete USB micro hole
    [ANNA-BoM.xlsx, Casing (Lower-Upper) ver01.STEP, Emma_Finished.obj, Emma_Finished.stl, bontor_mbed_lowpan_rev_d.sch, bontor_mbed_lowpan_rev_e.brd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]
2015-06-12 version g puts lcd directly on pcb
    [bontor_mbed_lowpan_rev_f.brd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]
2015-07-24 add mcb enhancer and add power switch on controller
    [Casing (Lower-Upper) ver01.STEP, bontor_mbed_lowpan_rev_g.brd, bontor_mbed_lowpan_rev_h.brd, bontor_mbed_lowpan_rev_h.sch, mcb-enhancer-complete.skp, mcb-enhancer-connector.skp, mcb-enhancer-terminal.skp, mcb-enhancer-v1.brd]
2015-07-24 add mcb enhancer BoM and gerber
    [Bella-BoM.xlsx, bontor_mbed_lowpan_rev_h.brd, bontor_mbed_lowpan_rev_h.sch, mcb-enhancer-v5.brd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]
2015-08-21 added on off button and remove LCD resstor
    [ANNA-BoM.xlsx, bontor_mbed_lowpan_rev_h.brd, bontor_mbed_lowpan_rev_h.sch]
2015-11-29 routing mcb-enhancer, not DRC/ERC-ed yet
    [ANNA-BoM.xlsx, mcb-enhancer-v5.brd, mcb-enhancer-v5.sch]
2015-12-18 repair silkscreen
    [Bella-BoM.xlsx, mcb-enhancer-complete.skp, mcb-enhancer-v5.brd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]
